daniel-kurushin/arm-quantum/old/Календарь/Календарь.docx

Июль
Пн | Вт | Ср | Чт | Пт | Сб | Вс
1) Создание прототипа | 2) Создание прототипа | 3) Создание прототипа | 4) Создание прототипа | 5) Создание прототипа | 6) Создание прототипа | 7) Создание прототипа
8) Создание прототипа | 9) Создание прототипа | 10) Создание прототипа | 11) Проекти- рование РМ-120 | 12) Создание Моделей, Печать Деталей | 13) Создание РМ-120 | 14) Создание Модели РМ-150
15) Написание ПО | 16) Написание ПО Создание Моделей | 17) Проекти- Рование РМ-220 и РМ-110, Написание ПО | 18) Проекти- Рование РМ-220 и РМ-110, Написание ПО | 19) Проекти- Рование РМ-220 и РМ-110, Написание ПО | 20) Создание модели и печать РМ-211 Написание ПО | 21) Создание Модели и печать РМ- 213 Написание ПО
22) Создание Модели и Печать РМ- 214, Написание ПО | 23) Сборка тестовой версии РМ- 210, Написание ПО | 24) Сборка тестовой версии РМ-210 | 25) Сборка тестовой версии РМ-110 | 26) Сборка Тестовой версии РМ-110 | 27) Проекти-рование РМ-250, Написание ПО | 28) Проекти-рование РМ-261, РМ-262, РМ-263.
29) Написание ПО | 30) Написание ПО, Проведение тестов | 31) Написание ПО, Проведение тестов

Август
Пн | Вт | Ср | Чт | Пт | Сб | Вс
| | | 1) Сборка РМ-210 | 2) Сборка РМ-210 | 3) Сборка РМ-210 | 4) Сборка РМ-210
5) Сборка РМ-110 | 6) Сборка РМ-110 | 7) Сборка РМ-110 | 8) Написание ПО | 9) Написание ПО | 10) Написание ПО | 11) Проекти-рование РМ-220
12) Проекти-рование РМ-220 | 13) Проекти-рование РМ-220 | 14) Создание моделей РМ-220 | 15) Создание моделей РМ-220 | 16) Создание моделей РМ-220 | 17) Написание ПО, Проведение тестов | 18) Написание ПО, Проведение тестов
19) Печать моделей | 20) Печать моделей | 21) Проведение тестов | 22) Проектирование РМ-500 | 23) Проектирование РМ-500 | 24) Создание моделей | 25) Написание ПО
26) | 27) | 28) | 29) | 30) | 31)
