daniel-kurushin/arm-quantum/IMG_20211010_125608.jpg

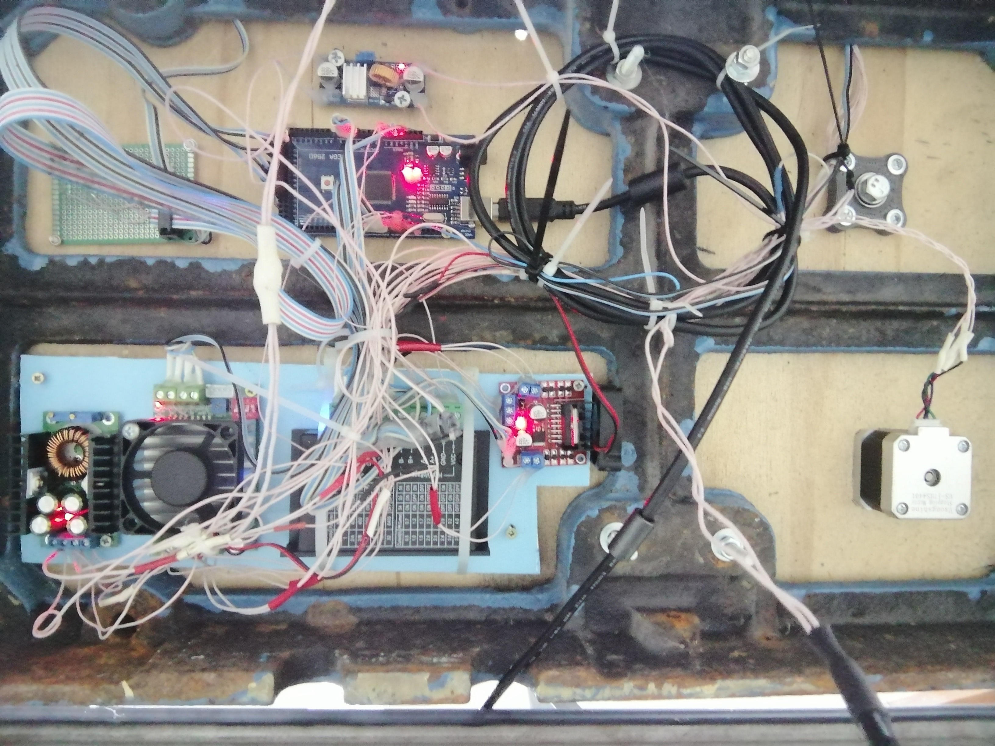
IMG_20211010_125608.jpg
