daniel-kurushin/arm-quantum/res.png

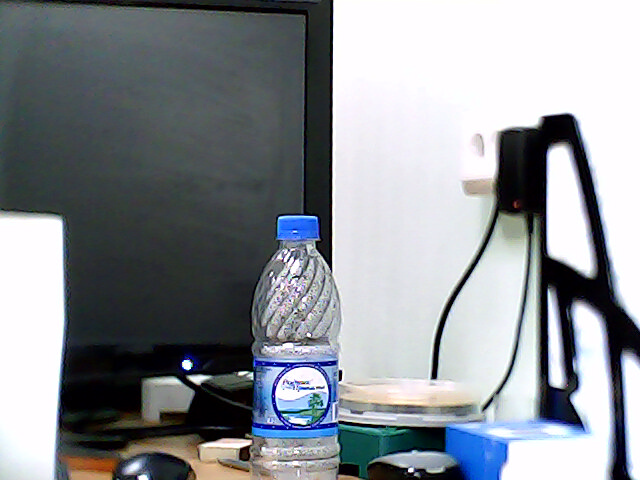
res.png
