daniel-kurushin/arm-quantum/РМ-000 Рука-манипулятор/РМ-100 Шасси/2.jpeg

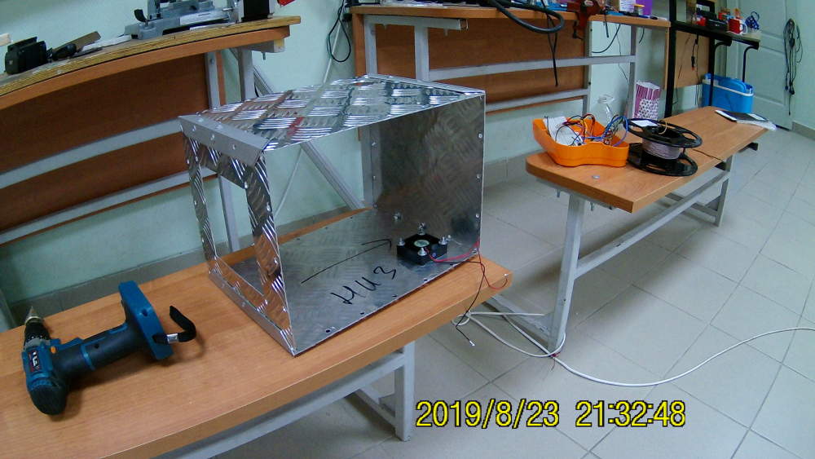
РМ-000 Рука-манипулятор/РМ-100 Шасси/2.jpeg
