daniel-kurushin/arm-quantum/РМ-000 Рука-манипулятор/РМ-100 Шасси/3.jpeg

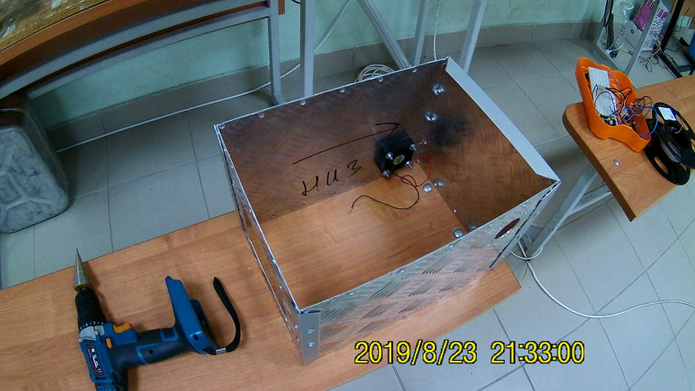
РМ-000 Рука-манипулятор/РМ-100 Шасси/3.jpeg
