daniel-kurushin/arm-quantum/РМ-000 Рука-манипулятор/РМ-100 Шасси/РМ-110 Корпус/корпус.jpeg

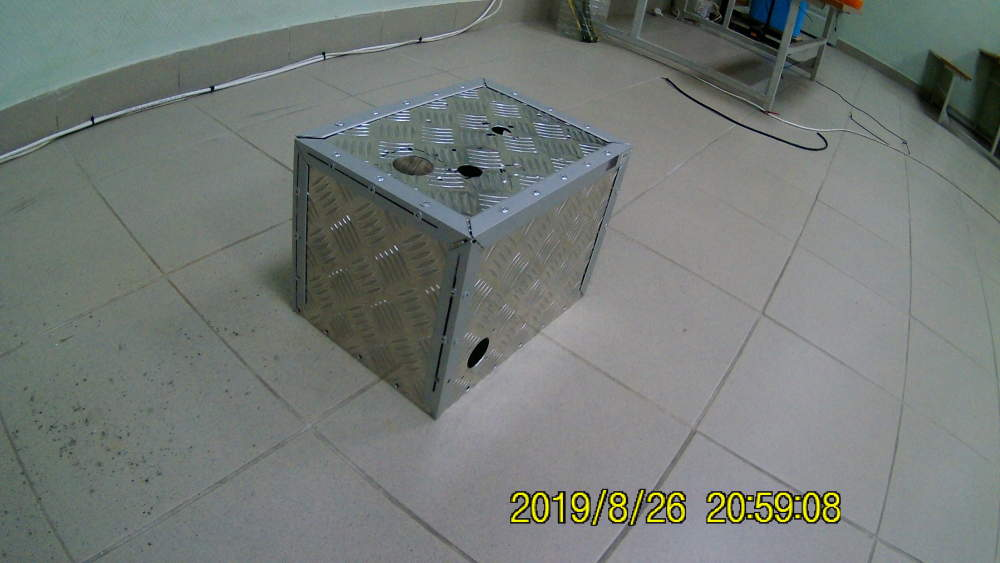
РМ-000 Рука-манипулятор/РМ-100 Шасси/РМ-110 Корпус/корпус.jpeg
