daniel-kurushin/arm-quantum/РМ-000 Рука-манипулятор/РМ-100 Шасси/РМ-120 Винтовые упоры/IMG_20190822_140116.jpg

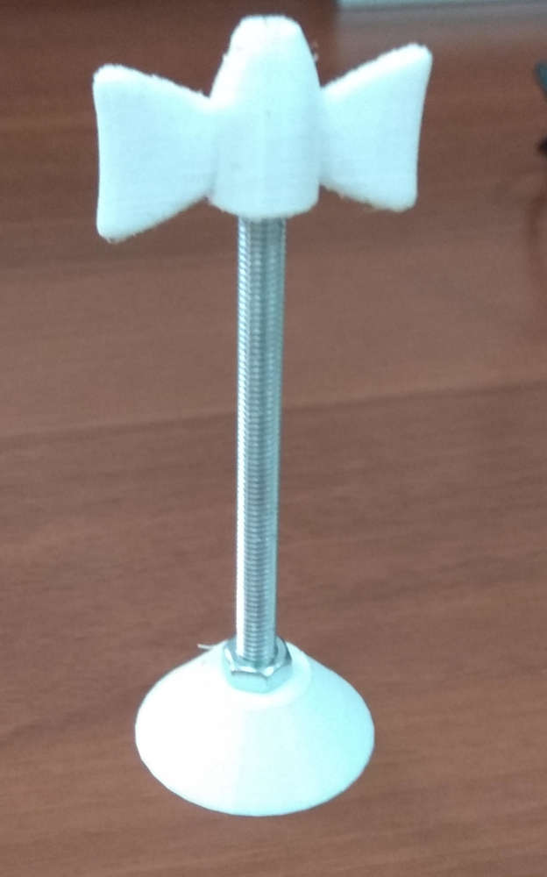
РМ-000 Рука-манипулятор/РМ-100 Шасси/РМ-120 Винтовые упоры/IMG_20190822_140116.jpg
