daniel-kurushin/arm-quantum/РМ-000 Рука-манипулятор/РМ-200 Опорно-поворотное устройство/предварительная_сборка.jpg

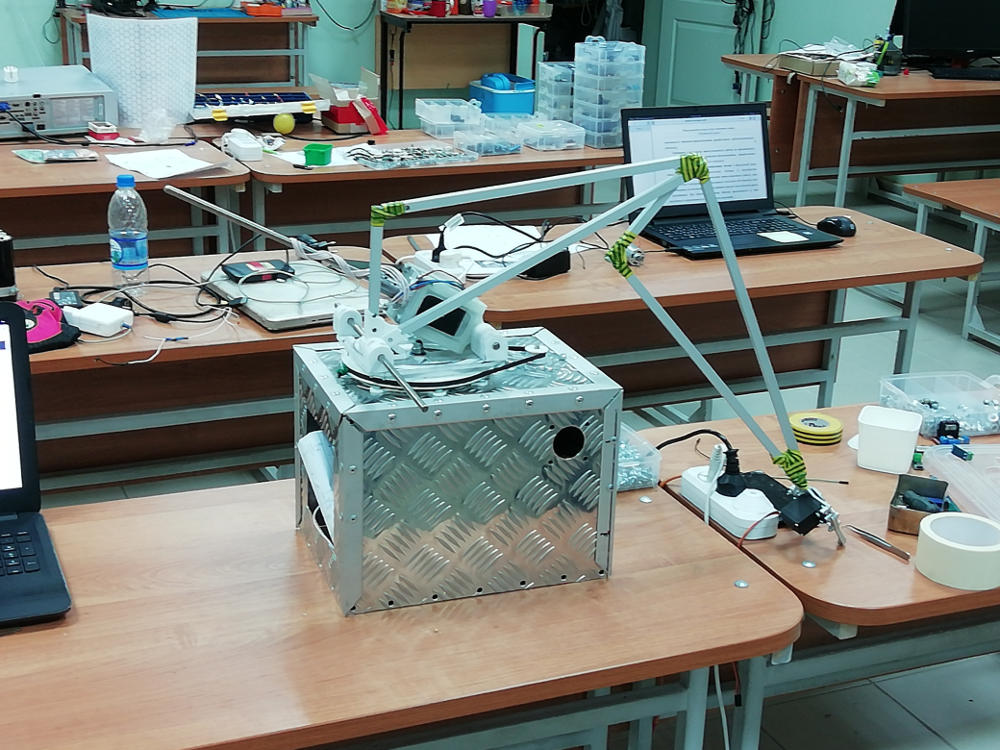
РМ-000 Рука-манипулятор/РМ-200 Опорно-поворотное устройство/предварительная_сборка.jpg
