daniel-kurushin/arm-quantum/РМ-000 Рука-манипулятор/РМ-200 Опорно-поворотное устройство/РМ-220 Стрела/FHD0012.JPG

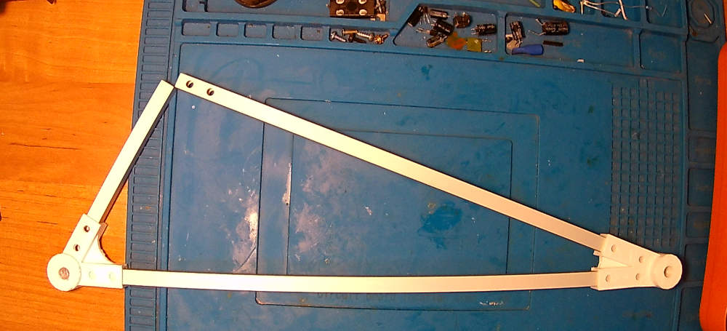
РМ-000 Рука-манипулятор/РМ-200 Опорно-поворотное устройство/РМ-220 Стрела/FHD0012.JPG
