daniel-kurushin/arm-quantum/РМ-000 Рука-манипулятор/РМ-200 Опорно-поворотное устройство/РМ-220 Стрела/крепеж_стрелы_1_(тест).jpg

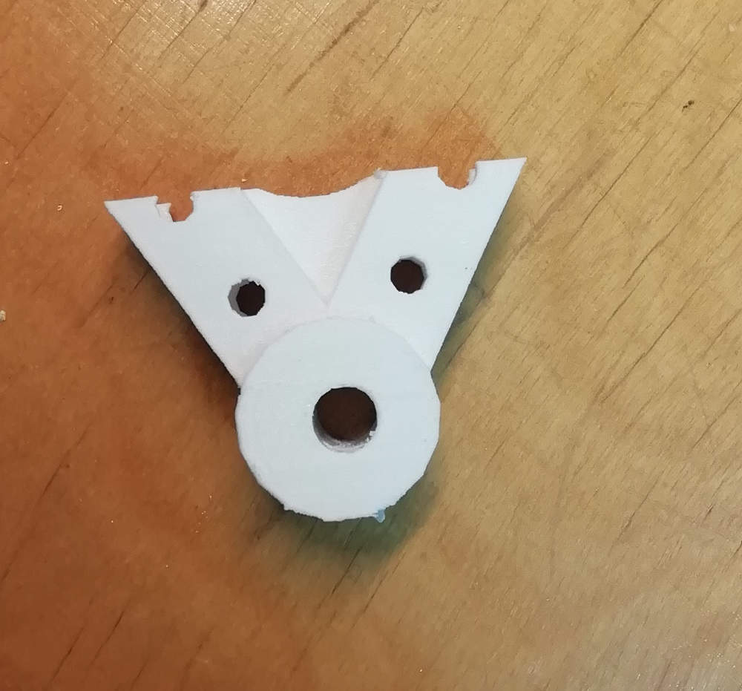
РМ-000 Рука-манипулятор/РМ-200 Опорно-поворотное устройство/РМ-220 Стрела/крепеж_стрелы_1_(тест).jpg
