daniel-kurushin/arm-quantum/РМ-000 Рука-манипулятор/РМ-200 Опорно-поворотное устройство/РМ-261 Привод РМ-220/РМ-261-01 Корпус опорных подшипников РМ-261-09 для дивгателя РМ-261-04/FHD0003.JPG

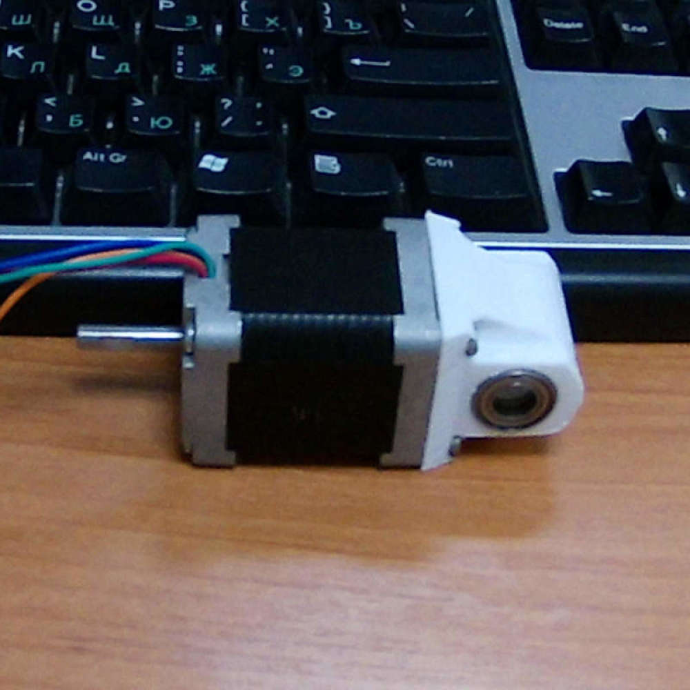
РМ-000 Рука-манипулятор/РМ-200 Опорно-поворотное устройство/РМ-261 Привод РМ-220/РМ-261-01 Корпус опорных подшипников РМ-261-09 для дивгателя РМ-261-04/FHD0003.JPG
