daniel-kurushin/arm-quantum/РМ-000 Рука-манипулятор/РМ-200 Опорно-поворотное устройство/РМ-261 Привод РМ-220/РМ-261-02 Корпус РМ-261-05/FHD0001.JPG

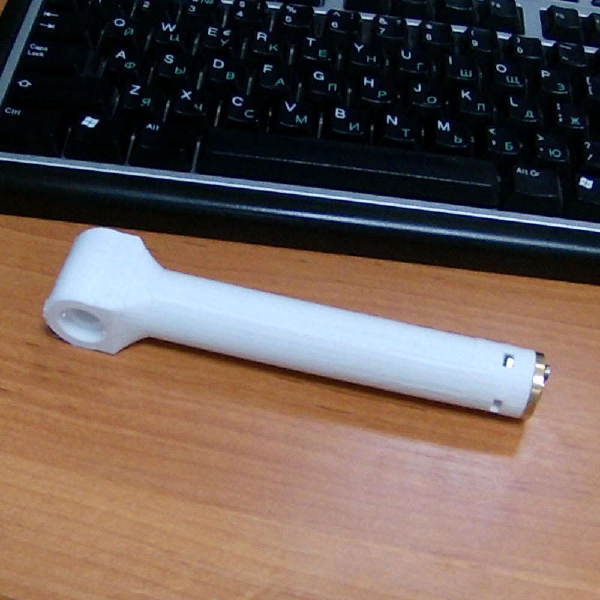
РМ-000 Рука-манипулятор/РМ-200 Опорно-поворотное устройство/РМ-261 Привод РМ-220/РМ-261-02 Корпус РМ-261-05/FHD0001.JPG
