daniel-kurushin/arm-quantum/РМ-000 Рука-манипулятор/РМ-200 Опорно-поворотное устройство/РМ-261 Привод РМ-220/РМ-261-03 Муфта соединительная (взамен покупной)/FHD0006.JPG

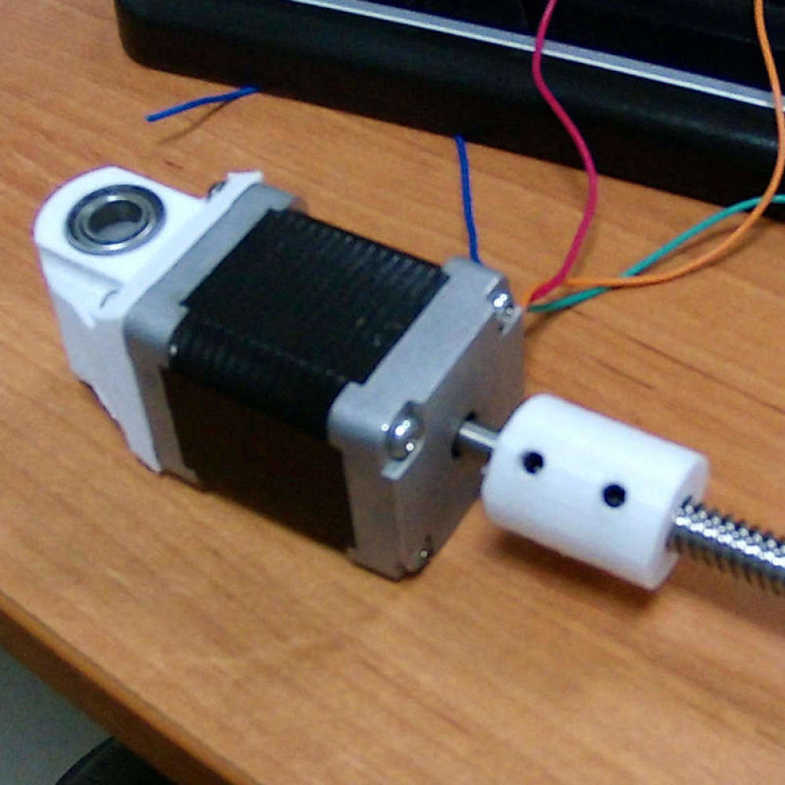
РМ-000 Рука-манипулятор/РМ-200 Опорно-поворотное устройство/РМ-261 Привод РМ-220/РМ-261-03 Муфта соединительная (взамен покупной)/FHD0006.JPG
