daniel-kurushin/arm-quantum/РМ-000 Рука-манипулятор/РМ-300 Блок управления/РМ-330 Драйвера приводов/драйвера_ШД.jpg

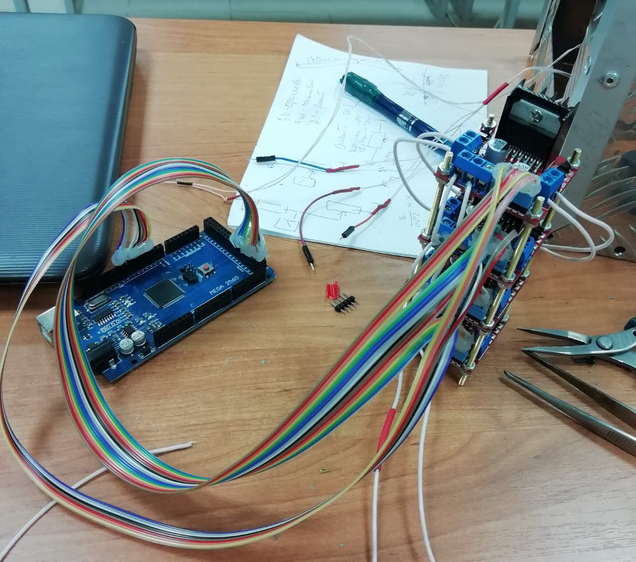
РМ-000 Рука-манипулятор/РМ-300 Блок управления/РМ-330 Драйвера приводов/драйвера_ШД.jpg
