daniel-kurushin/arm-quantum/РМ-000 Рука-манипулятор/РМ-400 Система технического зрения/РМ-430 Программное обеспечение/РМ-431 Распознавание образов/capacitor/1.jpg

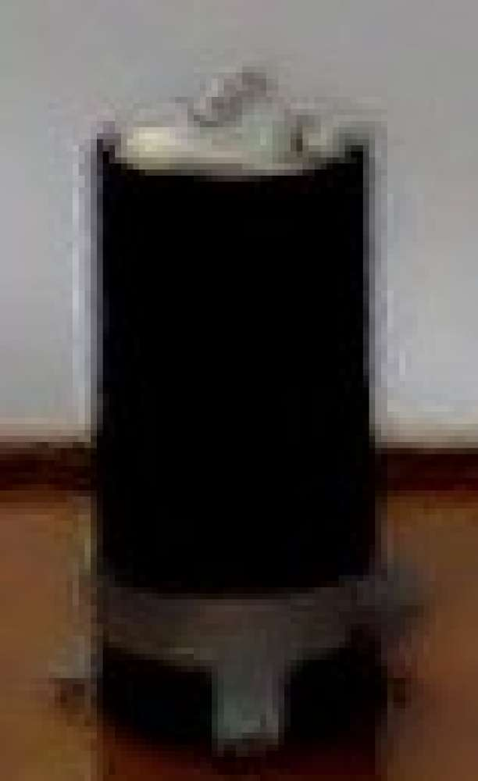
РМ-000 Рука-манипулятор/РМ-400 Система технического зрения/РМ-430 Программное обеспечение/РМ-431 Распознавание образов/capacitor/1.jpg
