daniel-kurushin/arm-quantum/РМ-000 Рука-манипулятор/РМ-100 Шасси/РМ-110 Корпус/плита переходная.stl

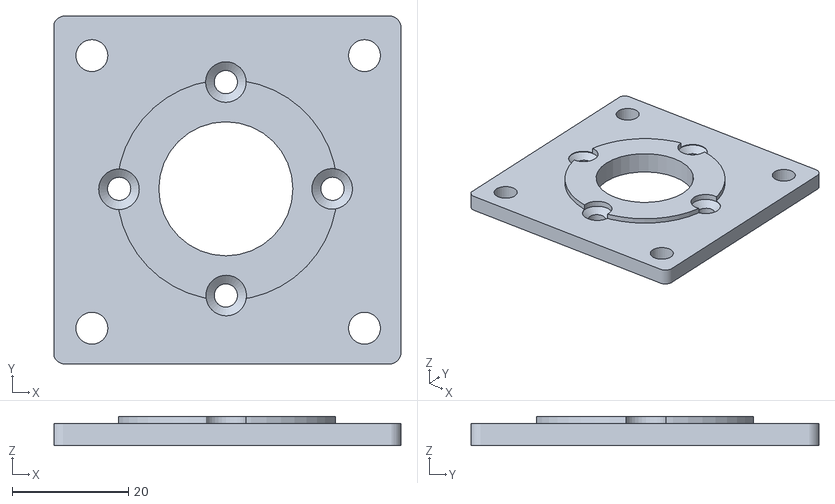
[picture p50: CAD file, 2019-09-23]
РМ-000 Рука-манипулятор/РМ-100 Шасси/РМ-110 Корпус/плита переходная.stl
59.8 x 59.9 x 5.00
