daniel-kurushin/arm-quantum/РМ-000 Рука-манипулятор/РМ-100 Шасси/РМ-120 Винтовые упоры/Кронштейн-1.stl

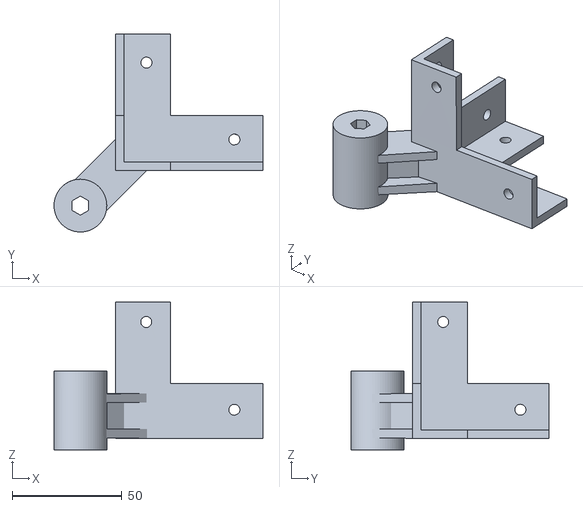
[picture p51: CAD file, 2019-09-15]
РМ-000 Рука-манипулятор/РМ-100 Шасси/РМ-120 Винтовые упоры/Кронштейн-1.stl
95.1 x 90.1 x 67.2
