daniel-kurushin/arm-quantum/РМ-000 Рука-манипулятор/РМ-100 Шасси/РМ-150 Контейнер АКБ/РМ-151 АКБ/АКБ-1.stl

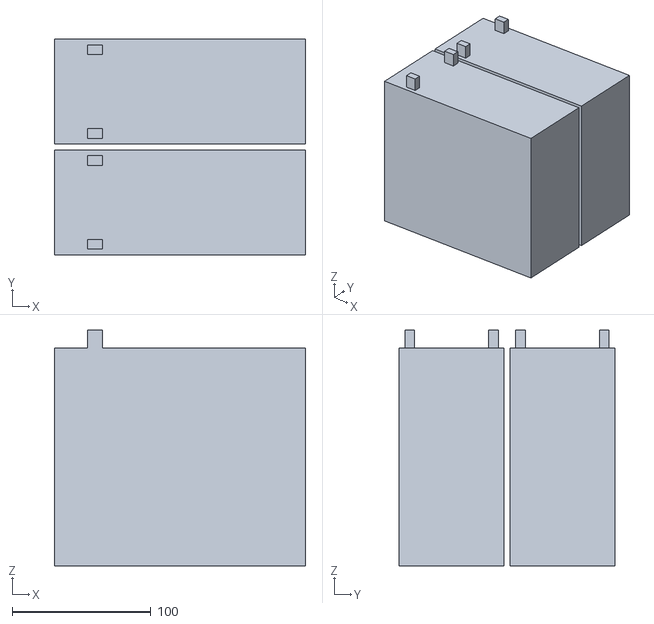
[picture p52: CAD file, 2019-08-23]
РМ-000 Рука-манипулятор/РМ-100 Шасси/РМ-150 Контейнер АКБ/РМ-151 АКБ/АКБ-1.stl
181.0 x 156.0 x 170.0
