daniel-kurushin/arm-quantum/РМ-000 Рука-манипулятор/РМ-100 Шасси/шкив датчика_1.stl

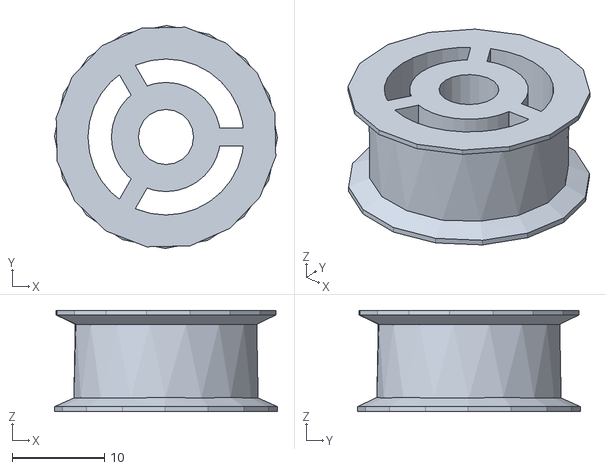
[picture p53: CAD file, 2019-10-10]
РМ-000 Рука-манипулятор/РМ-100 Шасси/шкив датчика_1.stl
24.2 x 24.2 x 11.0
