daniel-kurushin/arm-quantum/РМ-000 Рука-манипулятор/РМ-200 Опорно-поворотное устройство/РМ-210 Поворотный механизм/РМ-211 Узел осевого подшипника/РМ-211-01 Корпус подшипников оси/Корпус подшипника.stl

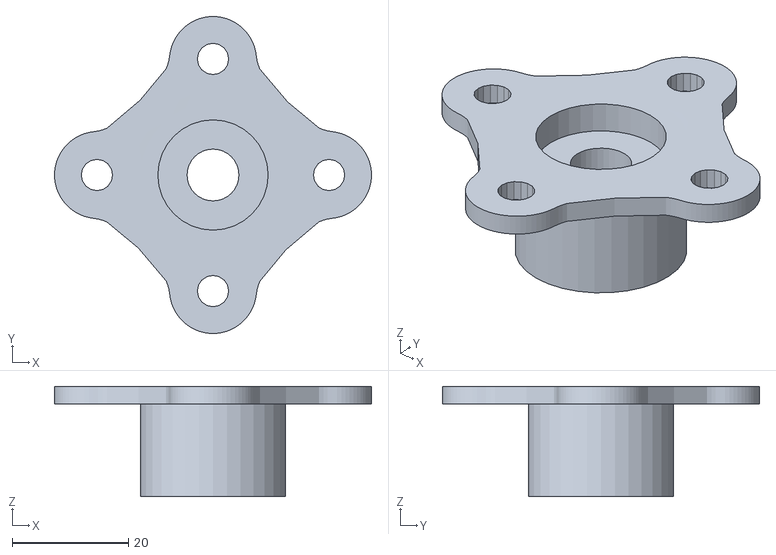
[picture p54: CAD file, 2019-08-14]
РМ-000 Рука-манипулятор/РМ-200 Опорно-поворотное устройство/РМ-210 Поворотный механизм/РМ-211 Узел осевого подшипника/РМ-211-01 Корпус подшипников оси/Корпус подшипника.stl
54.6 x 54.6 x 19.0
