daniel-kurushin/arm-quantum/РМ-000 Рука-манипулятор/РМ-200 Опорно-поворотное устройство/РМ-210 Поворотный механизм/РМ-212 Узел опорного подшипника/РМ-212-02 Сепаратор опорного подшипника/Cепаратор опорного подшипника.stl

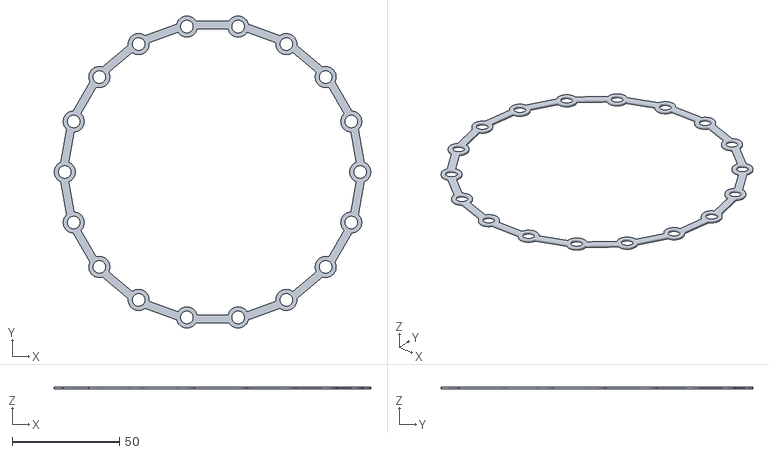
[picture p56: CAD file, 2019-08-13]
РМ-000 Рука-манипулятор/РМ-200 Опорно-поворотное устройство/РМ-210 Поворотный механизм/РМ-212 Узел опорного подшипника/РМ-212-02 Сепаратор опорного подшипника/Cепаратор опорного подшипника.stl
148.0 x 145.8 x 1.00
