daniel-kurushin/arm-quantum/РМ-000 Рука-манипулятор/РМ-200 Опорно-поворотное устройство/РМ-210 Поворотный механизм/РМ-213 Узел натяжителя (датчика положения)/РМ-213-01 Корпус натяжителя/корпус.stl

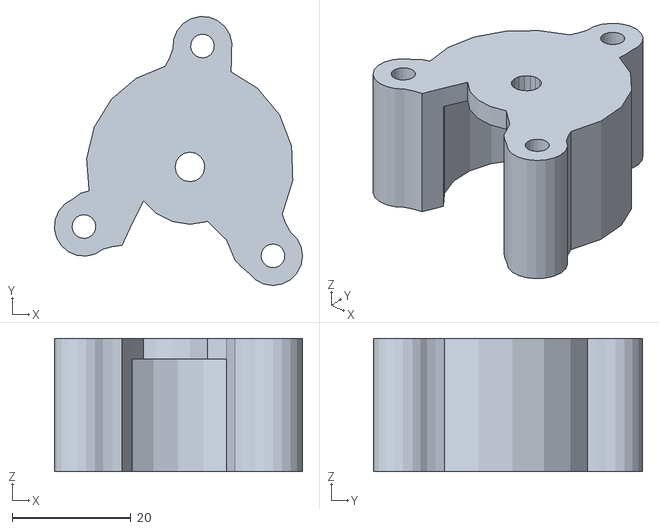
[picture p57: CAD file, 2019-08-18]
РМ-000 Рука-манипулятор/РМ-200 Опорно-поворотное устройство/РМ-210 Поворотный механизм/РМ-213 Узел натяжителя (датчика положения)/РМ-213-01 Корпус натяжителя/корпус.stl
41.9 x 45.4 x 22.5
