daniel-kurushin/arm-quantum/РМ-000 Рука-манипулятор/РМ-200 Опорно-поворотное устройство/РМ-210 Поворотный механизм/РМ-213 Узел натяжителя (датчика положения)/РМ-213-02 Крышка корпуса натяжителя/крышка.stl

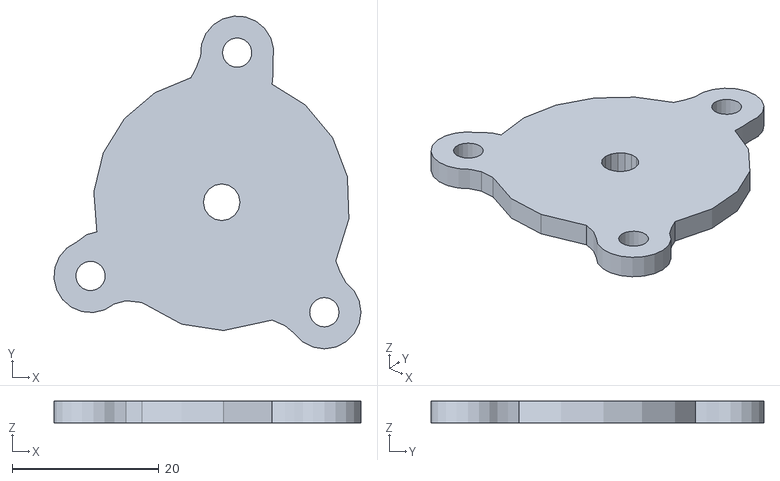
[picture p58: CAD file, 2019-08-18]
РМ-000 Рука-манипулятор/РМ-200 Опорно-поворотное устройство/РМ-210 Поворотный механизм/РМ-213 Узел натяжителя (датчика положения)/РМ-213-02 Крышка корпуса натяжителя/крышка.stl
41.9 x 45.4 x 3.00
