daniel-kurushin/arm-quantum/РМ-000 Рука-манипулятор/РМ-200 Опорно-поворотное устройство/РМ-210 Поворотный механизм/РМ-213 Узел натяжителя (датчика положения)/РМ-213-04 Шкив натяжителя (датчика положения)/шкив-1.stl

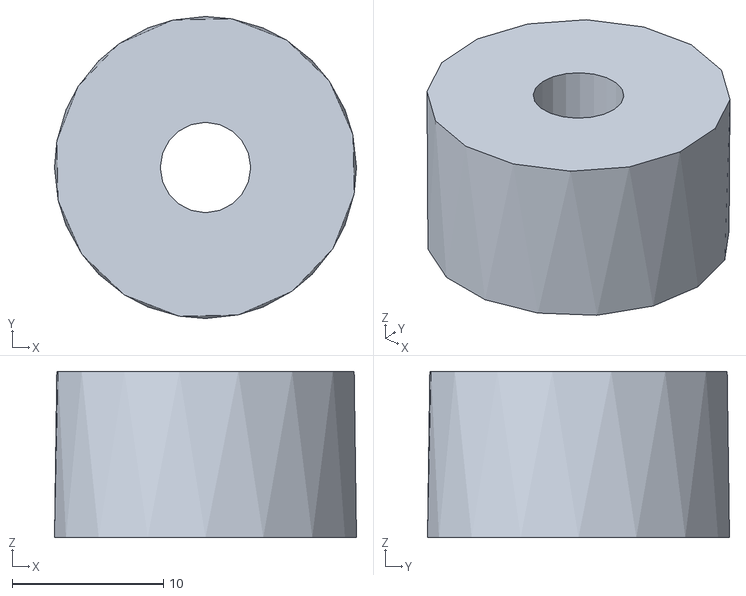
[picture p59: CAD file, 2019-08-19]
РМ-000 Рука-манипулятор/РМ-200 Опорно-поворотное устройство/РМ-210 Поворотный механизм/РМ-213 Узел натяжителя (датчика положения)/РМ-213-04 Шкив натяжителя (датчика положения)/шкив-1.stl
20.0 x 20.0 x 11.0
