daniel-kurushin/arm-quantum/РМ-000 Рука-манипулятор/РМ-200 Опорно-поворотное устройство/РМ-210 Поворотный механизм/РМ-213 Узел натяжителя (датчика положения)/РМ-213-07 Поворотный рычаг шкива (держатель РМ-213-03)/рычаг.stl

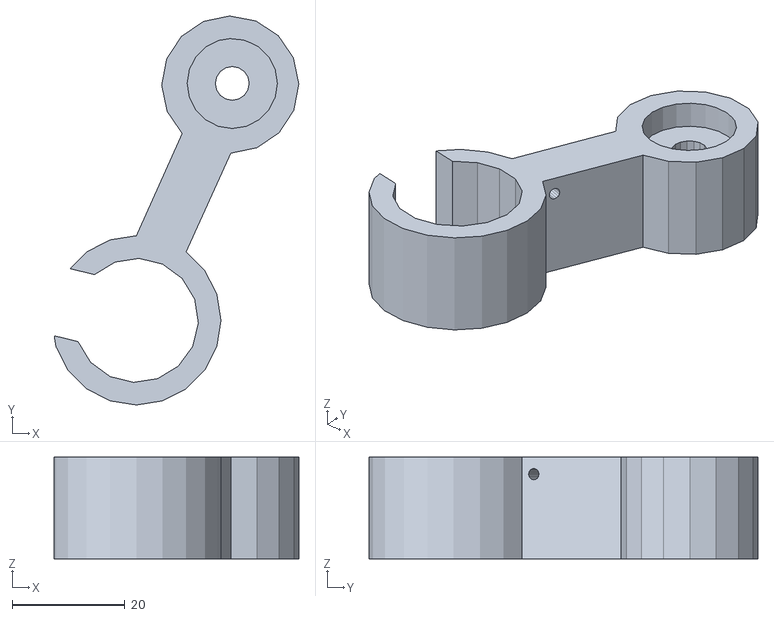
[picture p60: CAD file, 2019-08-18]
РМ-000 Рука-манипулятор/РМ-200 Опорно-поворотное устройство/РМ-210 Поворотный механизм/РМ-213 Узел натяжителя (датчика положения)/РМ-213-07 Поворотный рычаг шкива (держатель РМ-213-03)/рычаг.stl
43.4 x 68.9 x 18.0
