daniel-kurushin/arm-quantum/РМ-000 Рука-манипулятор/РМ-200 Опорно-поворотное устройство/РМ-210 Поворотный механизм/РМ-214 Узел поворотного основания/РМ-214-01 Шкив ведомый с верхней обоймой опорного подшипника/ Шкив ведомый-1.stl

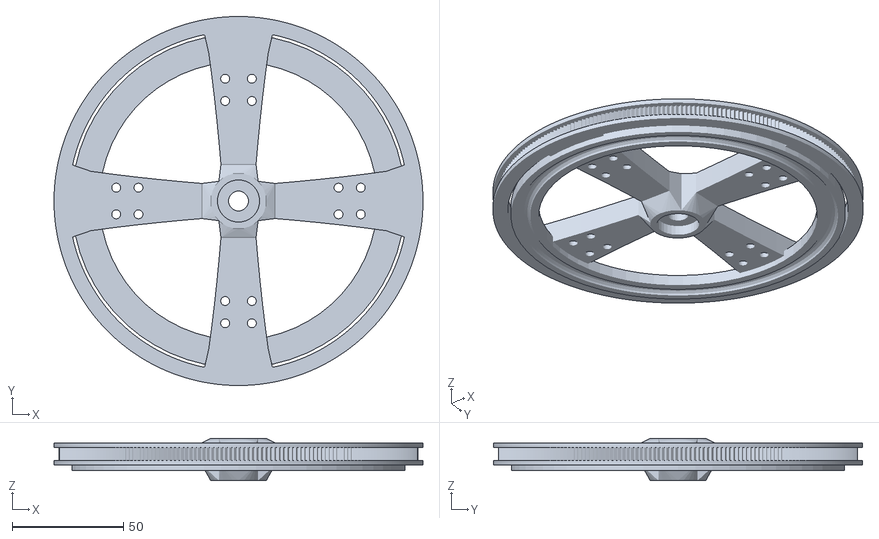
[picture p61: CAD file, 2019-08-21]
РМ-000 Рука-манипулятор/РМ-200 Опорно-поворотное устройство/РМ-210 Поворотный механизм/РМ-214 Узел поворотного основания/РМ-214-01 Шкив ведомый с верхней обоймой опорного подшипника/ Шкив ведомый-1.s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
166.0 x 166.0 x 19.0
