daniel-kurushin/arm-quantum/РМ-000 Рука-манипулятор/РМ-200 Опорно-поворотное устройство/РМ-220 Стрела/подвес захвата.stl

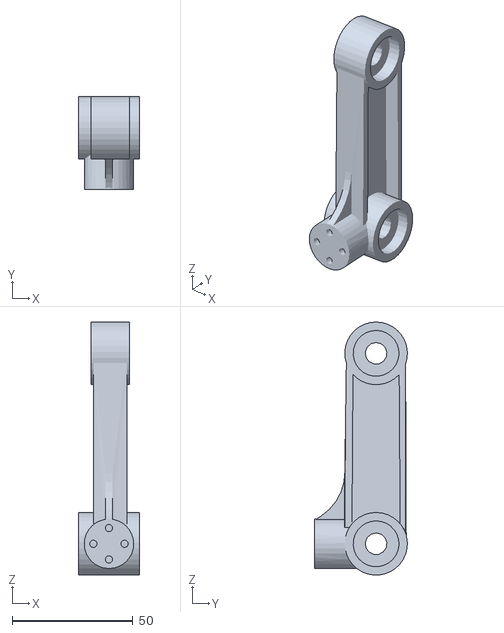
[picture p62: CAD file, 2019-09-23]
РМ-000 Рука-манипулятор/РМ-200 Опорно-поворотное устройство/РМ-220 Стрела/подвес захвата.stl
25.2 x 38.5 x 104.9
