daniel-kurushin/arm-quantum/РМ-000 Рука-манипулятор/РМ-200 Опорно-поворотное устройство/РМ-250 Привод РМ-210/Шкив ведущий.stl

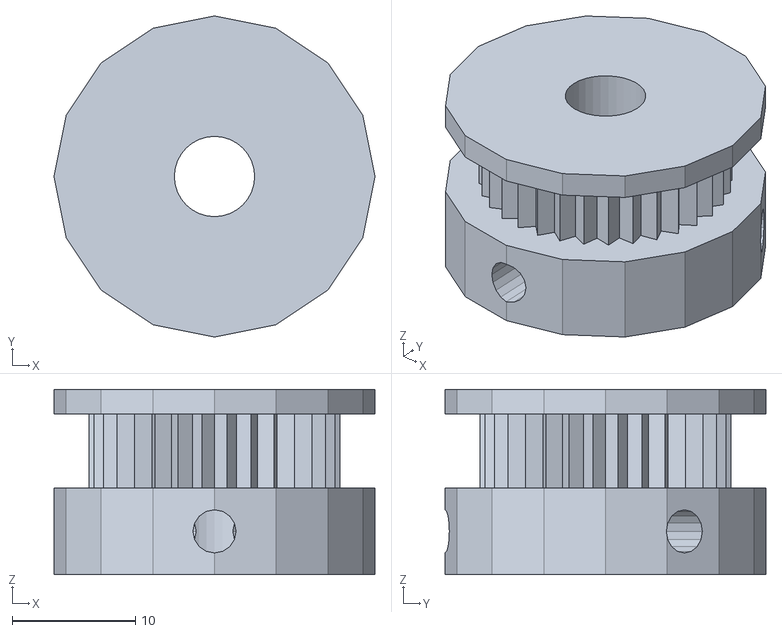
[picture p63: CAD file, 2019-08-14]
РМ-000 Рука-манипулятор/РМ-200 Опорно-поворотное устройство/РМ-250 Привод РМ-210/Шкив ведущий.stl
26.0 x 26.0 x 15.0
