daniel-kurushin/arm-quantum/РМ-000 Рука-манипулятор/РМ-200 Опорно-поворотное устройство/РМ-261 Привод РМ-220/РМ-261-01 Корпус опорных подшипников РМ-261-09 для дивгателя РМ-261-04/РМ-261-01-1.stl

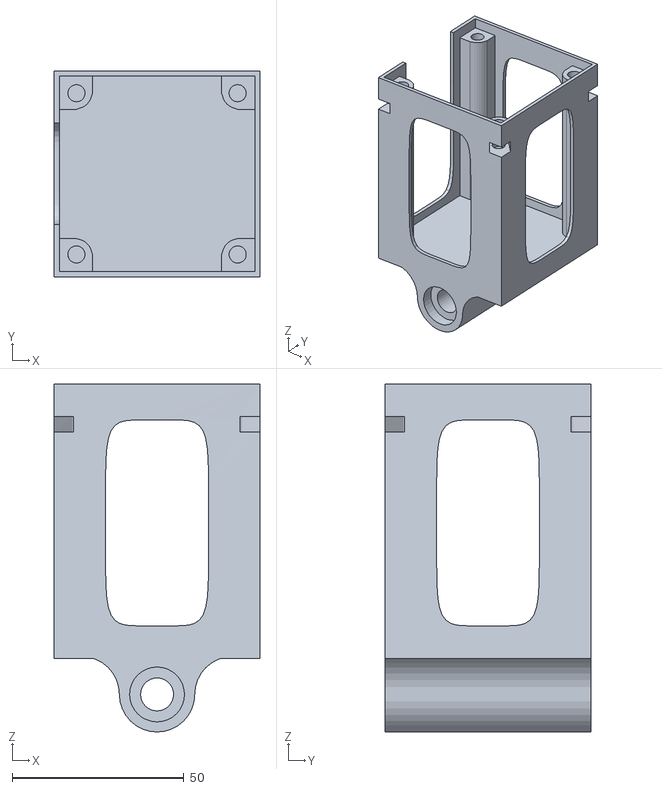
[picture p64: CAD file, 2019-08-11]
РМ-000 Рука-манипулятор/РМ-200 Опорно-поворотное устройство/РМ-261 Привод РМ-220/РМ-261-01 Корпус опорных подшипников РМ-261-09 для дивгателя РМ-261-04/РМ-261-01-1.stl
60.0 x 60.1 x 101.4
