daniel-kurushin/arm-quantum/РМ-000 Рука-манипулятор/РМ-200 Опорно-поворотное устройство/РМ-261 Привод РМ-220/РМ-261-03 Муфта соединительная (взамен покупной)/РМ-261-03.stl

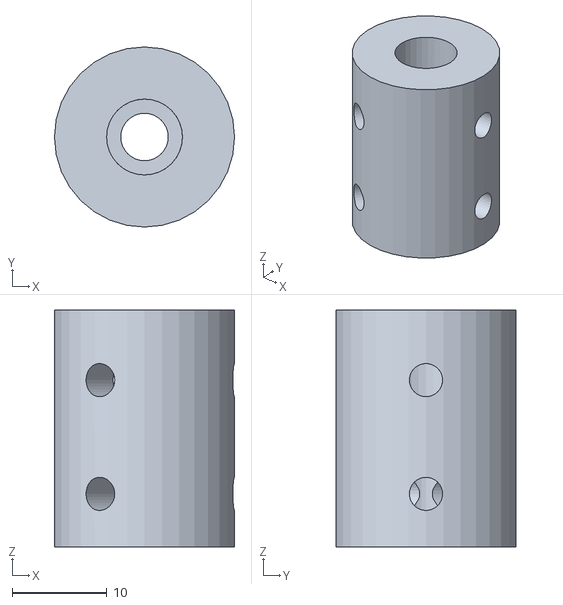
[picture p65: CAD file, 2019-08-09]
РМ-000 Рука-манипулятор/РМ-200 Опорно-поворотное устройство/РМ-261 Привод РМ-220/РМ-261-03 Муфта соединительная (взамен покупной)/РМ-261-03.stl
19.0 x 19.0 x 25.0
