daniel-kurushin/arm-quantum/РМ-000 Рука-манипулятор/РМ-200 Опорно-поворотное устройство/РМ-261 Привод РМ-220/РМ-261-04 Двигатель шаговый PL35HD45-D5/РМ-261-04 Двигатель шаговый.stl

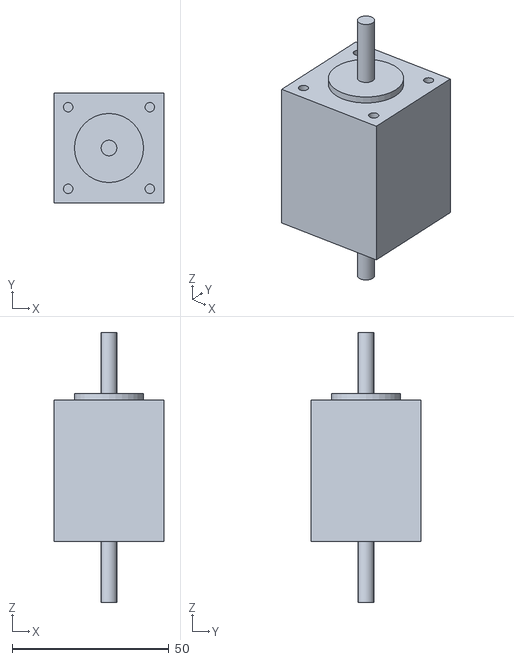
[picture p66: CAD file, 2019-08-09]
РМ-000 Рука-манипулятор/РМ-200 Опорно-поворотное устройство/РМ-261 Привод РМ-220/РМ-261-04 Двигатель шаговый PL35HD45-D5/РМ-261-04 Двигатель шаговый.stl
35.0 x 35.0 x 86.0
