daniel-kurushin/arm-quantum/РМ-000 Рука-манипулятор/РМ-200 Опорно-поворотное устройство/РМ-262 Привод РМ-230/РМ-262-01 Корпус опорных подшипников РМ-262-09 для дивгателя РМ-262-04/РМ-262-02.stl

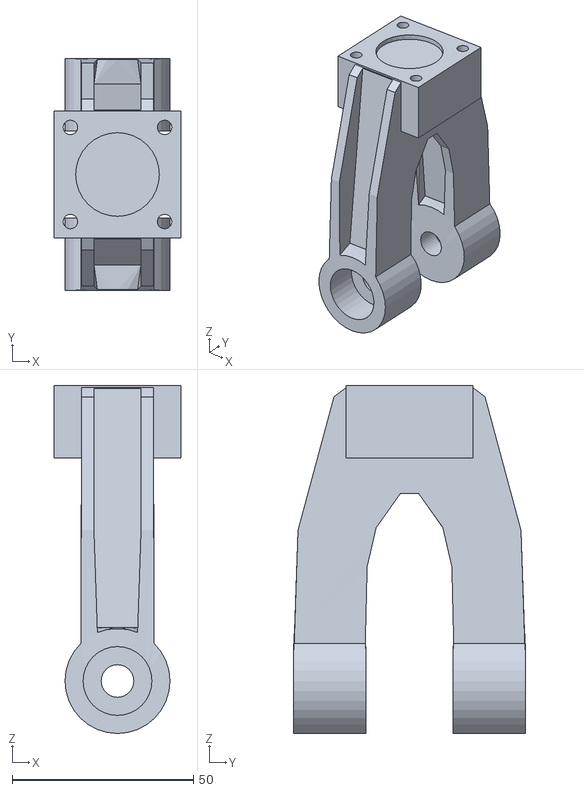
[picture p67: CAD file, 2019-09-19]
РМ-000 Рука-манипулятор/РМ-200 Опорно-поворотное устройство/РМ-262 Привод РМ-230/РМ-262-01 Корпус опорных подшипников РМ-262-09 для дивгателя РМ-262-04/РМ-262-02.stl
35.0 x 64.0 x 96.1
