daniel-kurushin/arm-quantum/РМ-000 Рука-манипулятор/РМ-200 Опорно-поворотное устройство/РМ-262 Привод РМ-230/РМ-262-02 Корпус РМ-262-05/РМ-262-02.stl

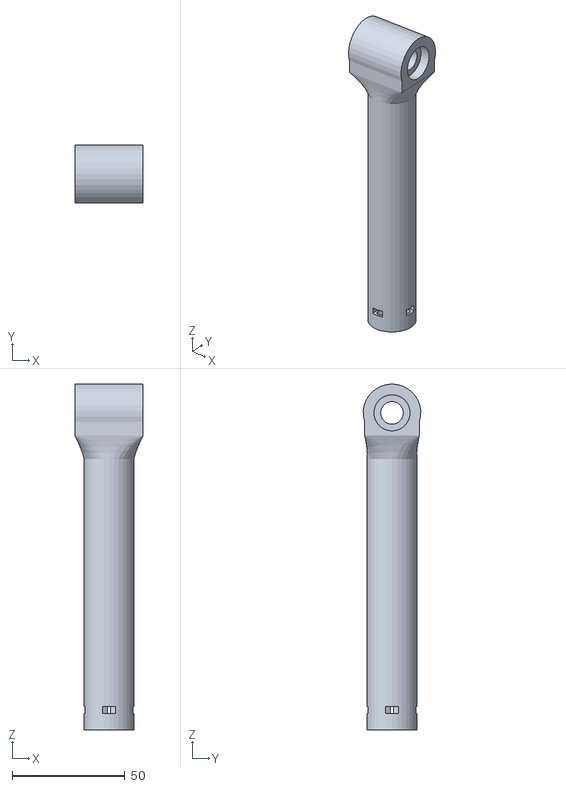
[picture p68: CAD file, 2019-08-08]
РМ-000 Рука-манипулятор/РМ-200 Опорно-поворотное устройство/РМ-262 Привод РМ-230/РМ-262-02 Корпус РМ-262-05/РМ-262-02.stl
30.3 x 25.5 x 153.1
