daniel-kurushin/arm-quantum/РМ-000 Рука-манипулятор/РМ-500 Схват/clawsl.stl

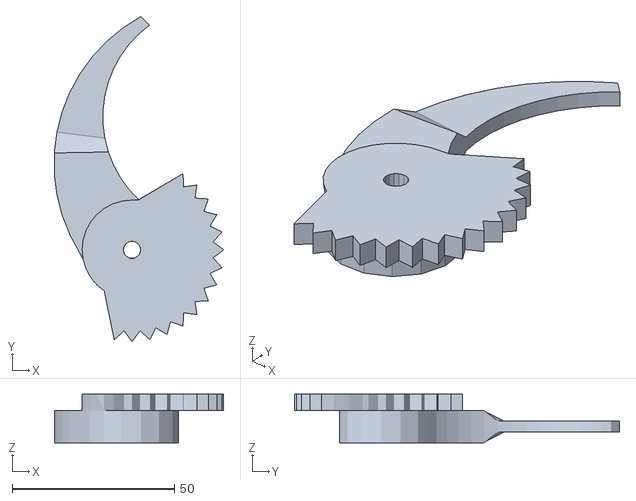
[picture p69: CAD file, 2021-01-24]
РМ-000 Рука-манипулятор/РМ-500 Схват/clawsl.stl
52.3 x 100.3 x 15.0
