daniel-kurushin/arm-quantum/РМ-000 Рука-манипулятор/РМ-600 Пульт управления/РМ-630 Управляющая ЭВМ/РМ-632 Устройства отображения информации/РМ-632-01 Кронштейн и корпус монитора/small-monitor-frame-a.stl

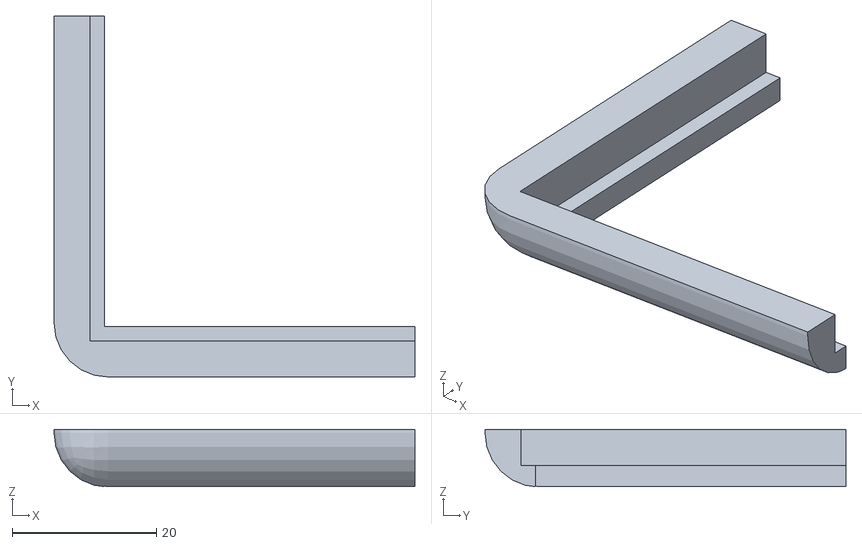
[picture p70: CAD file, 2021-10-18]
РМ-000 Рука-манипулятор/РМ-600 Пульт управления/РМ-630 Управляющая ЭВМ/РМ-632 Устройства отображения информации/РМ-632-01 Кронштейн и корпус монитора/small-monitor-frame-a.stl
50.0 x 50.0 x 7.93
