daniel-kurushin/arm-quantum/РМ-000 Рука-манипулятор/РМ-100 Шасси/РМ-110 Корпус/untitled.stl

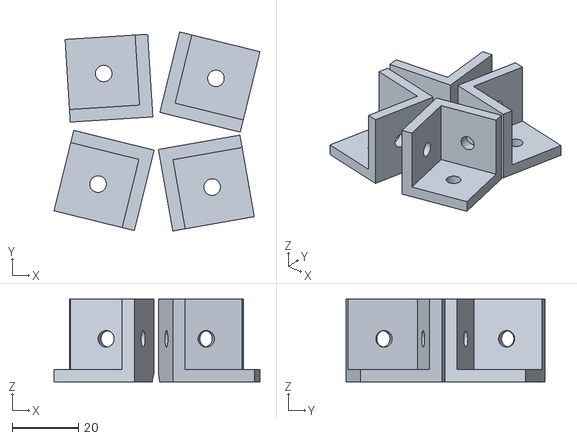
[picture p71: CAD file, 2019-08-31]
РМ-000 Рука-манипулятор/РМ-100 Шасси/РМ-110 Корпус/untitled.stl
62.2 x 60.1 x 25.0
