daniel-kurushin/arm-quantum/РМ-000 Рука-манипулятор/РМ-100 Шасси/РМ-120 Винтовые упоры/Кронштейн4.stl

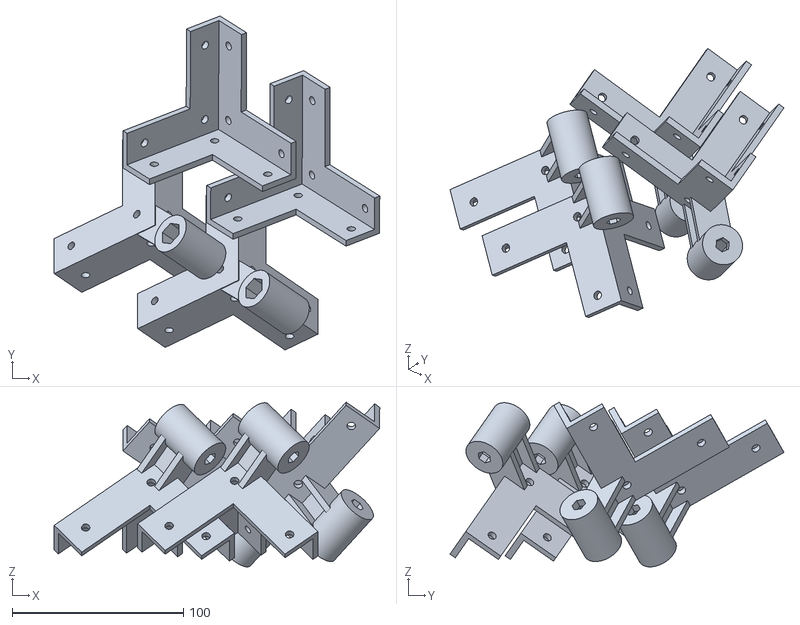
[picture p72: CAD file, 2019-08-21]
РМ-000 Рука-манипулятор/РМ-100 Шасси/РМ-120 Винтовые упоры/Кронштейн4.stl
190.3 x 195.2 x 96.3
