daniel-kurushin/arm-quantum/РМ-000 Рука-манипулятор/РМ-100 Шасси/РМ-150 Контейнер АКБ/РМ-151 АКБ/АКБ.stl

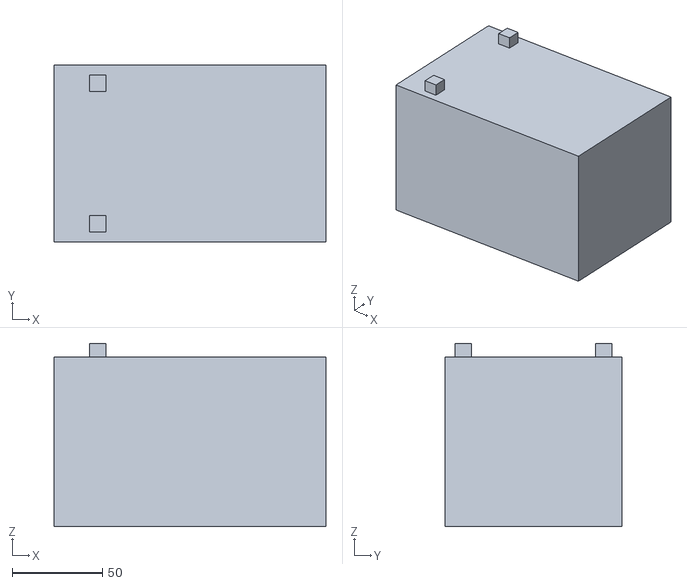
[picture p73: CAD file, 2019-08-23]
РМ-000 Рука-манипулятор/РМ-100 Шасси/РМ-150 Контейнер АКБ/РМ-151 АКБ/АКБ.stl
151.0 x 98.0 x 101.8
