daniel-kurushin/arm-quantum/РМ-000 Рука-манипулятор/РМ-200 Опорно-поворотное устройство/РМ-210 Поворотный механизм/РМ-212 Узел опорного подшипника/РМ-212-01 Обойма опорного подшипника нижняя/Опорный подшипник.stl

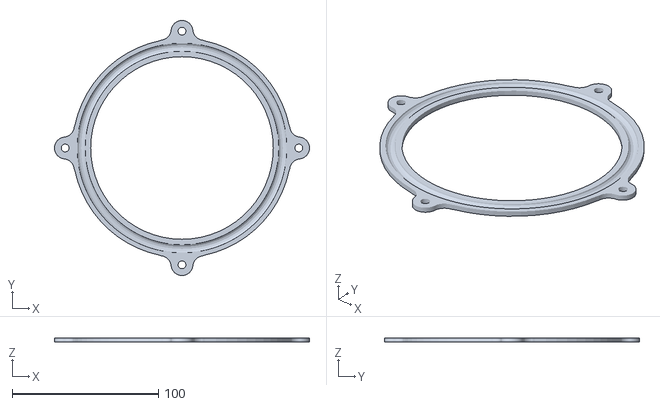
[picture p75: CAD file, 2019-08-13]
РМ-000 Рука-манипулятор/РМ-200 Опорно-поворотное устройство/РМ-210 Поворотный механизм/РМ-212 Узел опорного подшипника/РМ-212-01 Обойма опорного подшипника нижняя/Опорный подшипник.stl
174.6 x 174.6 x 3.00
