daniel-kurushin/arm-quantum/РМ-000 Рука-манипулятор/РМ-200 Опорно-поворотное устройство/РМ-210 Поворотный механизм/РМ-213 Узел натяжителя (датчика положения)/РМ-213-04 Шкив натяжителя (датчика положения)/шкив.stl

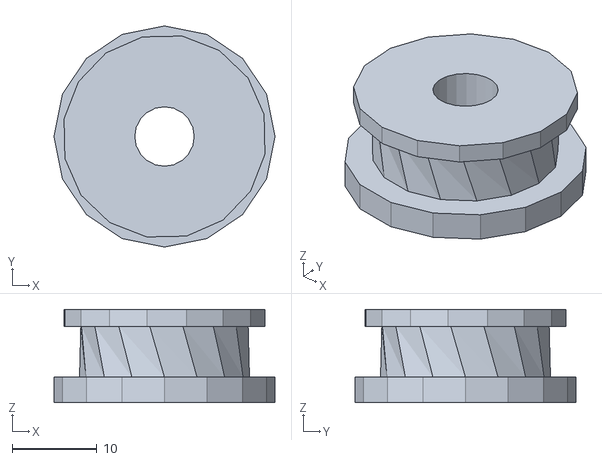
[picture p76: CAD file, 2019-08-14]
РМ-000 Рука-манипулятор/РМ-200 Опорно-поворотное устройство/РМ-210 Поворотный механизм/РМ-213 Узел натяжителя (датчика положения)/РМ-213-04 Шкив натяжителя (датчика положения)/шкив.stl
26.0 x 26.0 x 11.0
