daniel-kurushin/arm-quantum/РМ-000 Рука-манипулятор/РМ-200 Опорно-поворотное устройство/РМ-210 Поворотный механизм/РМ-214 Узел поворотного основания/РМ-214-01 Шкив ведомый с верхней обоймой опорного подшипника/ Шкив ведомый.stl

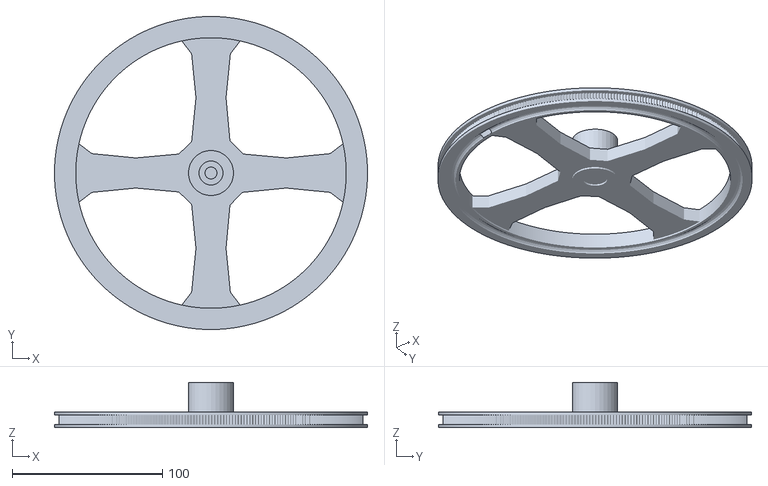
[picture p77: CAD file, 2019-08-10]
РМ-000 Рука-манипулятор/РМ-200 Опорно-поворотное устройство/РМ-210 Поворотный механизм/РМ-214 Узел поворотного основания/РМ-214-01 Шкив ведомый с верхней обоймой опорного подшипника/ Шкив ведомый.stl
208.0 x 208.0 x 30.0
