daniel-kurushin/arm-quantum/РМ-000 Рука-манипулятор/РМ-200 Опорно-поворотное устройство/РМ-220 Стрела/соединитель-6.stl

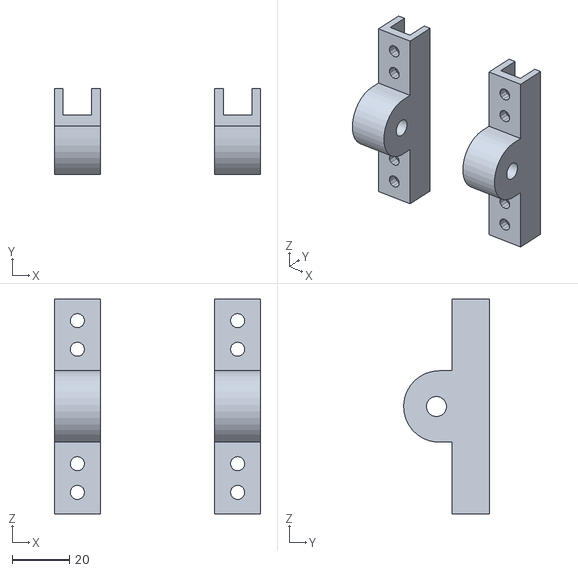
[picture p78: CAD file, 2019-09-23]
РМ-000 Рука-манипулятор/РМ-200 Опорно-поворотное устройство/РМ-220 Стрела/соединитель-6.stl
72.0 x 30.0 x 75.0
