daniel-kurushin/arm-quantum/РМ-000 Рука-манипулятор/РМ-200 Опорно-поворотное устройство/РМ-250 Привод РМ-210/Муфта соединительная.stl

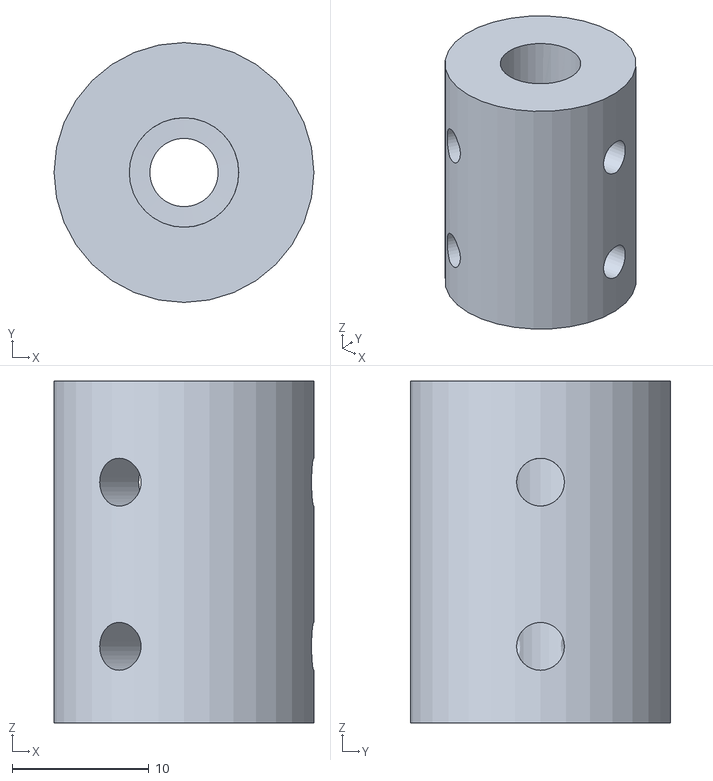
[picture p79: CAD file, 2019-08-10]
РМ-000 Рука-манипулятор/РМ-200 Опорно-поворотное устройство/РМ-250 Привод РМ-210/Муфта соединительная.stl
19.0 x 19.0 x 25.0
