daniel-kurushin/arm-quantum/РМ-000 Рука-манипулятор/РМ-200 Опорно-поворотное устройство/РМ-262 Привод РМ-230/РМ-262-01 Корпус опорных подшипников РМ-262-09 для дивгателя РМ-262-04/РМ-262-01.stl

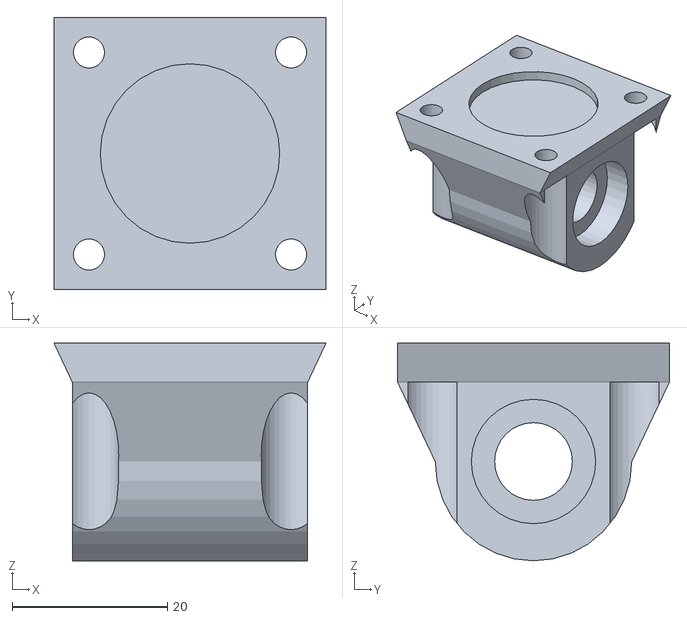
[picture p80: CAD file, 2019-08-08]
РМ-000 Рука-манипулятор/РМ-200 Опорно-поворотное устройство/РМ-262 Привод РМ-230/РМ-262-01 Корпус опорных подшипников РМ-262-09 для дивгателя РМ-262-04/РМ-262-01.stl
35.0 x 35.0 x 28.0
