daniel-kurushin/arm-quantum/РМ-000 Рука-манипулятор/РМ-500 Схват/clawsr.stl

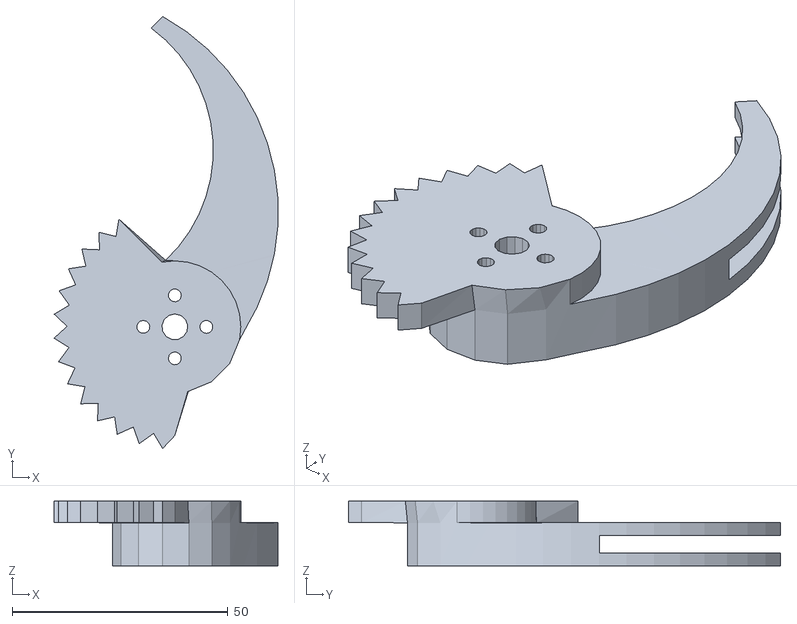
[picture p81: CAD file, 2021-01-24]
РМ-000 Рука-манипулятор/РМ-500 Схват/clawsr.stl
51.9 x 100.1 x 15.0
