daniel-kurushin/arm-quantum/РМ-000 Рука-манипулятор/РМ-100 Шасси/РМ-120 Винтовые упоры/Кронштейн.stl

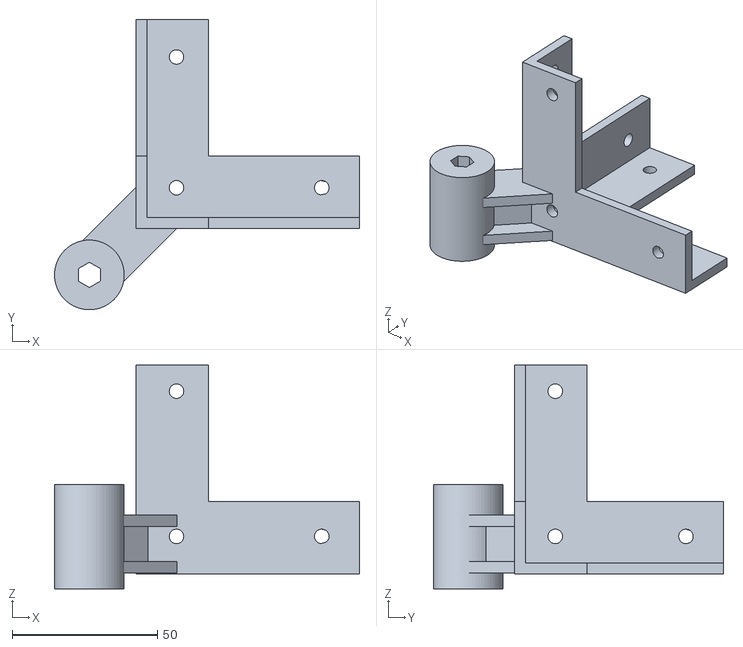
[picture p83: CAD file, 2019-08-21]
РМ-000 Рука-манипулятор/РМ-100 Шасси/РМ-120 Винтовые упоры/Кронштейн.stl
105.0 x 100.0 x 77.1
