daniel-kurushin/arm-quantum/РМ-000 Рука-манипулятор/РМ-100 Шасси/стойки для плат.stl

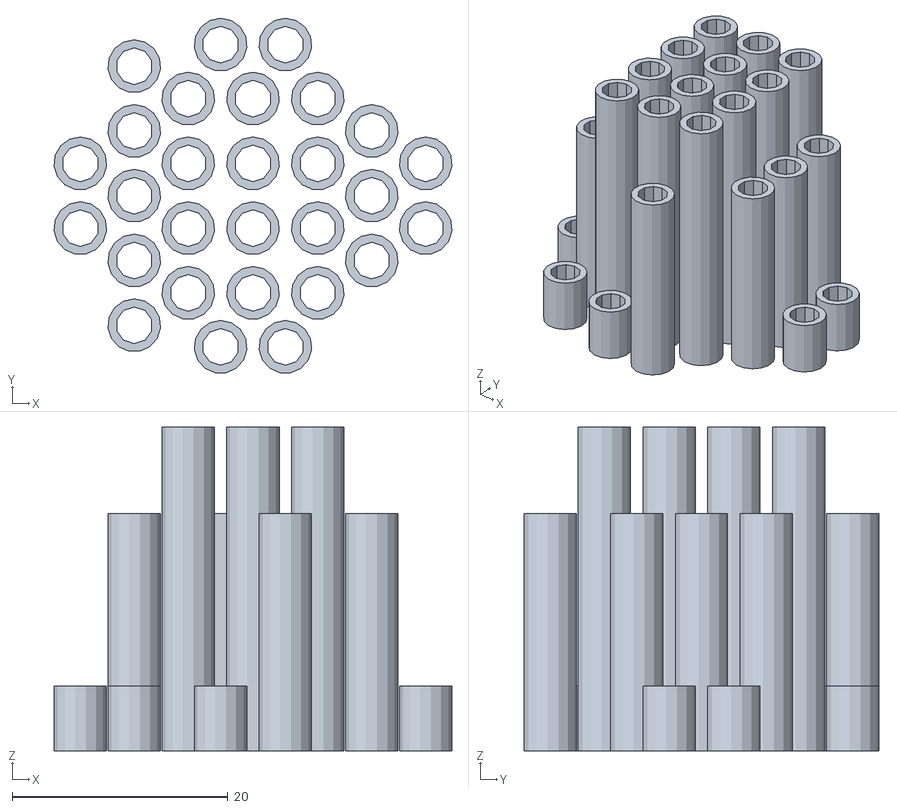
[picture p84: CAD file, 2019-09-15]
РМ-000 Рука-манипулятор/РМ-100 Шасси/стойки для плат.stl
36.9 x 32.8 x 30.0
