daniel-kurushin/arm-quantum/РМ-000 Рука-манипулятор/РМ-200 Опорно-поворотное устройство/РМ-220 Стрела/соединитель-8.stl

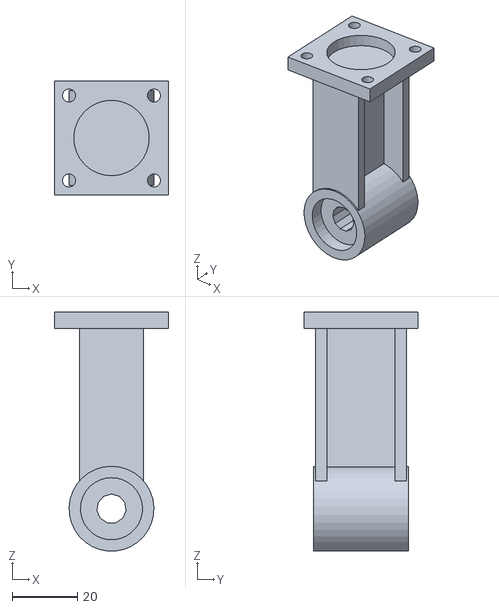
[picture p85: CAD file, 2019-09-23]
РМ-000 Рука-манипулятор/РМ-200 Опорно-поворотное устройство/РМ-220 Стрела/соединитель-8.stl
35.0 x 35.0 x 73.2
