daniel-kurushin/arm-quantum/РМ-000 Рука-манипулятор/РМ-200 Опорно-поворотное устройство/РМ-250 Привод РМ-210/Двигатель шаговый.stl

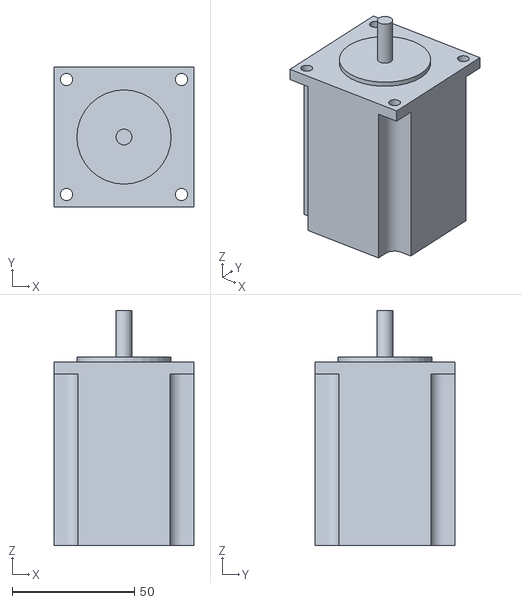
[picture p86: CAD file, 2019-08-10]
РМ-000 Рука-манипулятор/РМ-200 Опорно-поворотное устройство/РМ-250 Привод РМ-210/Двигатель шаговый.stl
57.0 x 57.0 x 96.0
