daniel-kurushin/arm-quantum/РМ-000 Рука-манипулятор/РМ-500 Схват/claws.stl

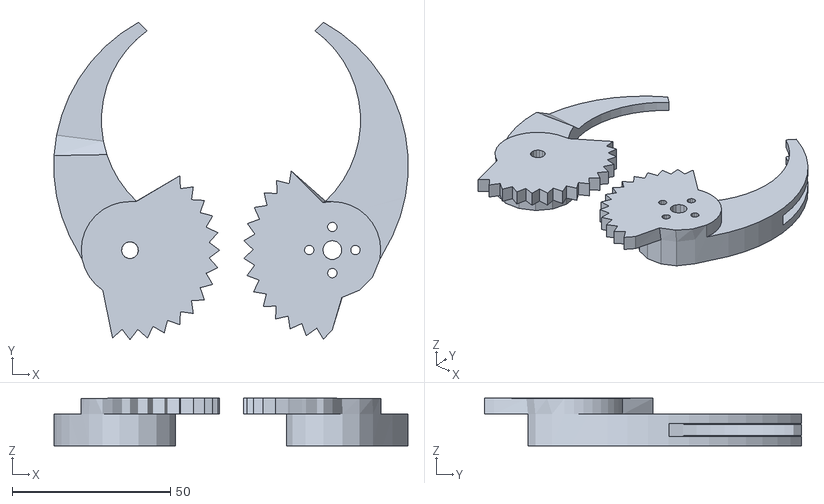
[picture p87: CAD file, 2021-01-24]
РМ-000 Рука-манипулятор/РМ-500 Схват/claws.stl
111.8 x 100.3 x 15.0
