daniel-kurushin/arm-quantum/РМ-000 Рука-манипулятор/РМ-100 Шасси/корпус турбины насоса-3.stl

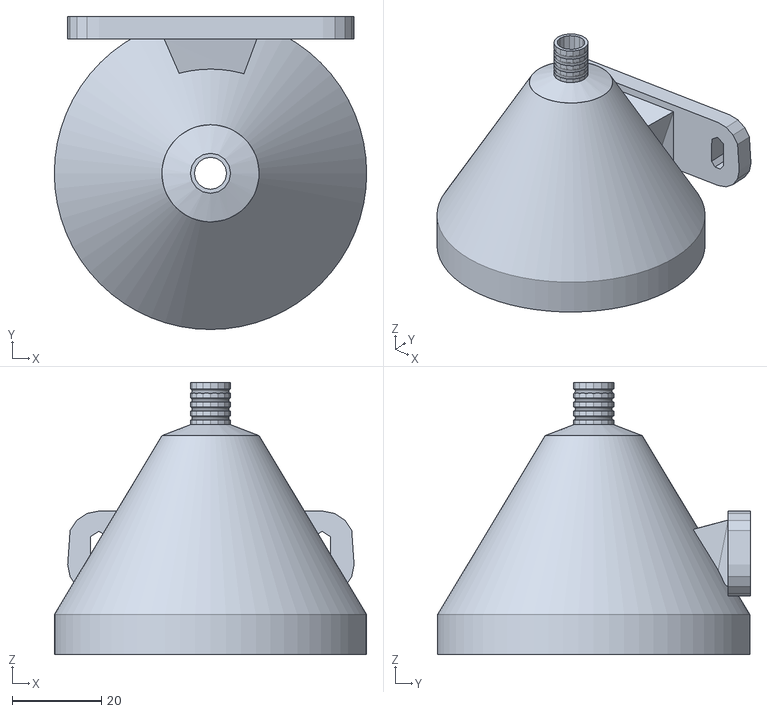
[picture p89: CAD file, 2019-09-15]
РМ-000 Рука-манипулятор/РМ-100 Шасси/корпус турбины насоса-3.stl
70.0 x 70.1 x 61.0
