daniel-kurushin/arm-quantum/РМ-000 Рука-манипулятор/РМ-100 Шасси/РМ-120 Винтовые упоры/Vrashalka.stl

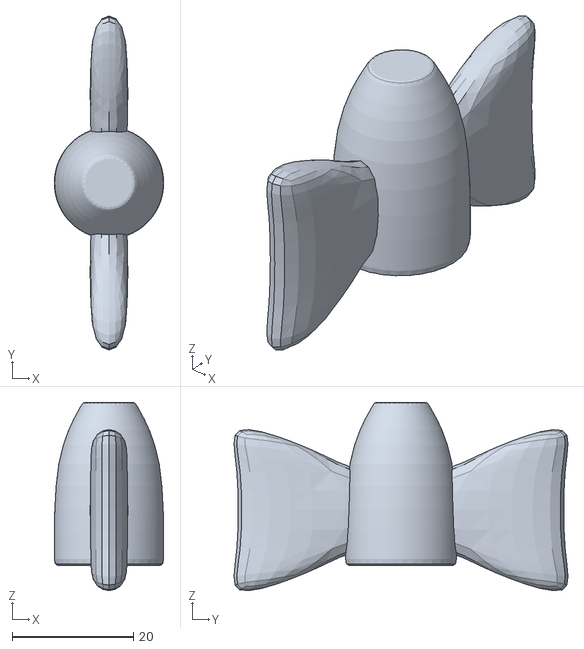
[picture p90: CAD file, 2019-08-21]
РМ-000 Рука-манипулятор/РМ-100 Шасси/РМ-120 Винтовые упоры/Vrashalka.stl
18.0 x 55.0 x 31.0
