daniel-kurushin/arm-quantum/РМ-000 Рука-манипулятор/РМ-200 Опорно-поворотное устройство/РМ-220 Стрела/соединитель-7.stl

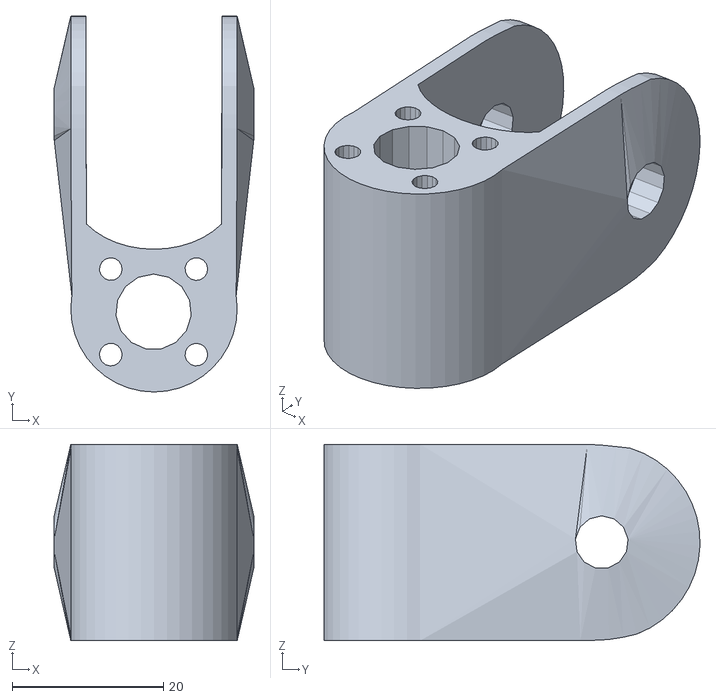
[picture p91: CAD file, 2019-09-23]
РМ-000 Рука-манипулятор/РМ-200 Опорно-поворотное устройство/РМ-220 Стрела/соединитель-7.stl
26.4 x 49.7 x 26.0
