daniel-kurushin/arm-quantum/РМ-000 Рука-манипулятор/РМ-500 Схват/clawsb.stl

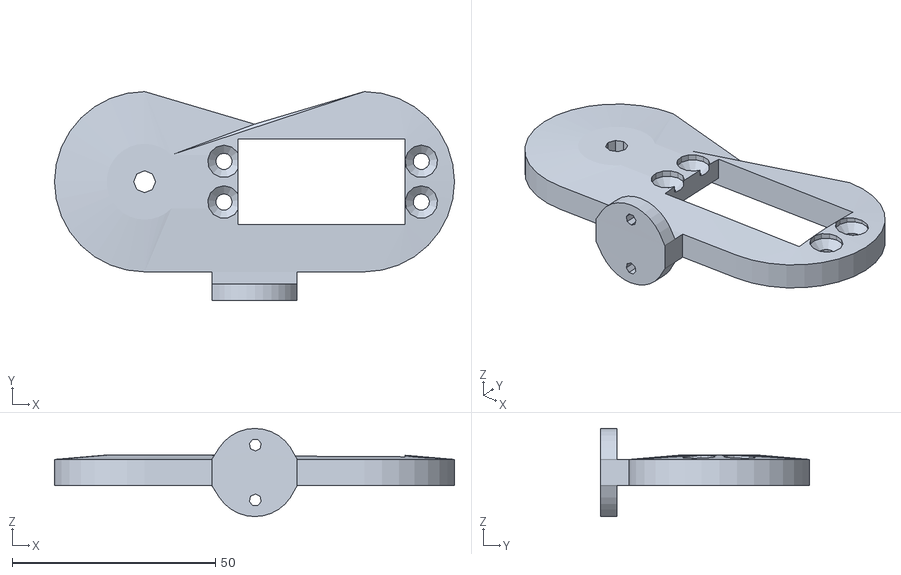
[picture p92: CAD file, 2019-09-27]
РМ-000 Рука-манипулятор/РМ-500 Схват/clawsb.stl
98.3 x 51.3 x 21.7
