daniel-kurushin/arm-quantum/РМ-000 Рука-манипулятор/РМ-600 Пульт управления/РМ-630 Управляющая ЭВМ/РМ-632 Устройства отображения информации/РМ-632-01 Кронштейн и корпус монитора/small-monitor-frame-h.stl

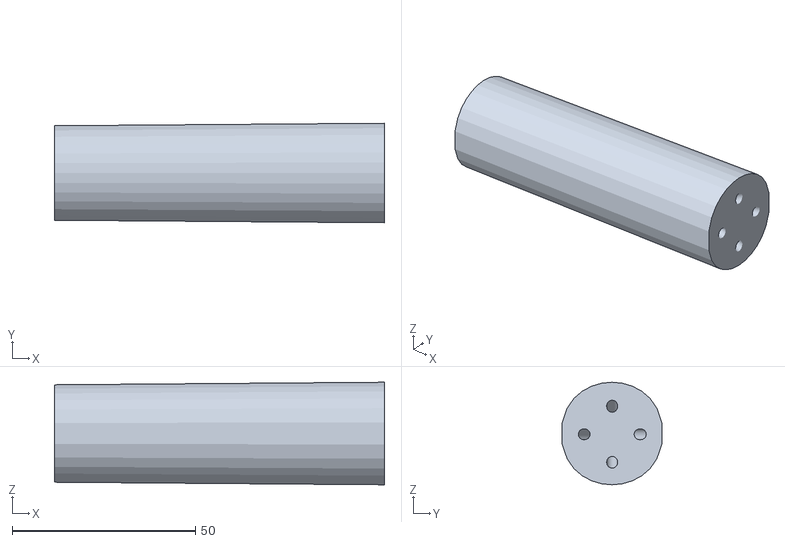
[picture p93: CAD file, 2021-10-18]
РМ-000 Рука-манипулятор/РМ-600 Пульт управления/РМ-630 Управляющая ЭВМ/РМ-632 Устройства отображения информации/РМ-632-01 Кронштейн и корпус монитора/small-monitor-frame-h.stl
90.0 x 27.1 x 28.0
