daniel-kurushin/arm-quantum/РМ-000 Рука-манипулятор/РМ-100 Шасси/пружинная вставка.stl

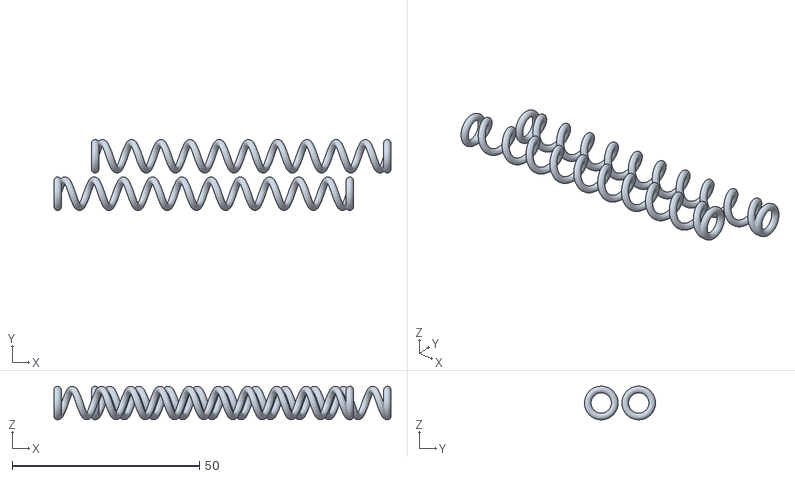
[picture p94: CAD file, 2019-09-15]
РМ-000 Рука-манипулятор/РМ-100 Шасси/пружинная вставка.stl
90.0 x 19.0 x 9.00
