daniel-kurushin/arm-quantum/РМ-000 Рука-манипулятор/РМ-100 Шасси/РМ-120 Винтовые упоры/Упор.stl

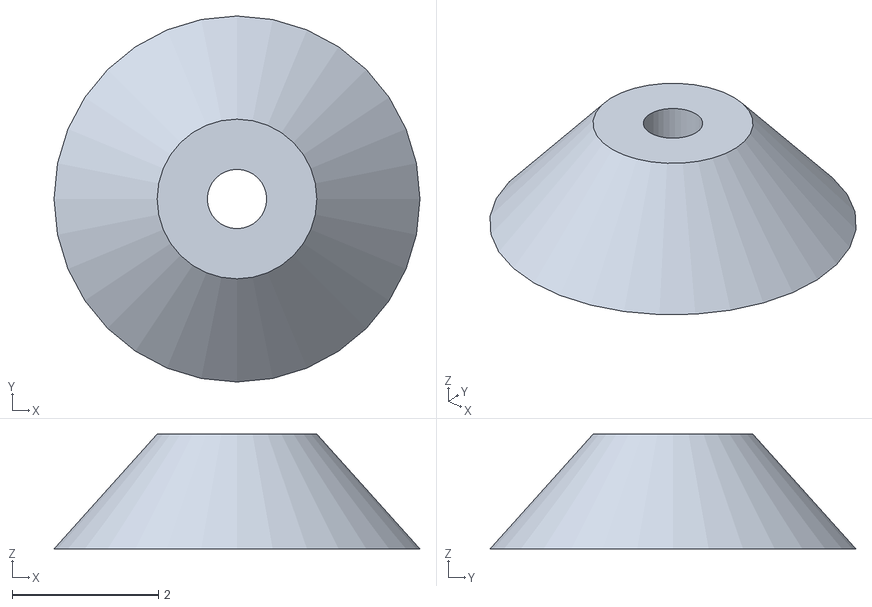
[picture p95: CAD file, 2019-08-21]
РМ-000 Рука-манипулятор/РМ-100 Шасси/РМ-120 Винтовые упоры/Упор.stl
5.00 x 5.00 x 1.57
