daniel-kurushin/arm-quantum/РМ-000 Рука-манипулятор/РМ-200 Опорно-поворотное устройство/РМ-220 Стрела/соединитель-2.stl

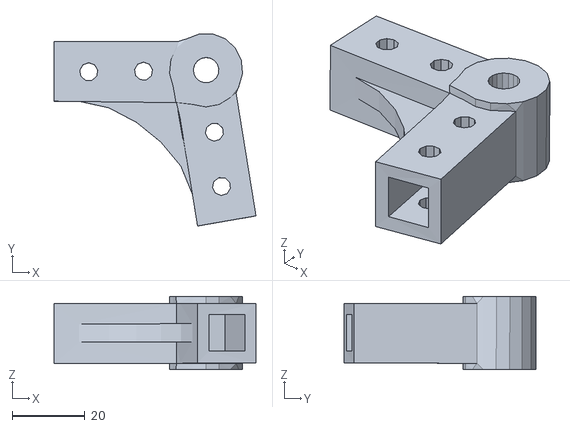
[picture p96: CAD file, 2019-09-15]
РМ-000 Рука-манипулятор/РМ-200 Опорно-поворотное устройство/РМ-220 Стрела/соединитель-2.stl
55.4 x 52.7 x 20.0
