daniel-kurushin/arm-quantum/РМ-000 Рука-манипулятор/РМ-100 Шасси/крыльчатка турбины насоса-2.stl

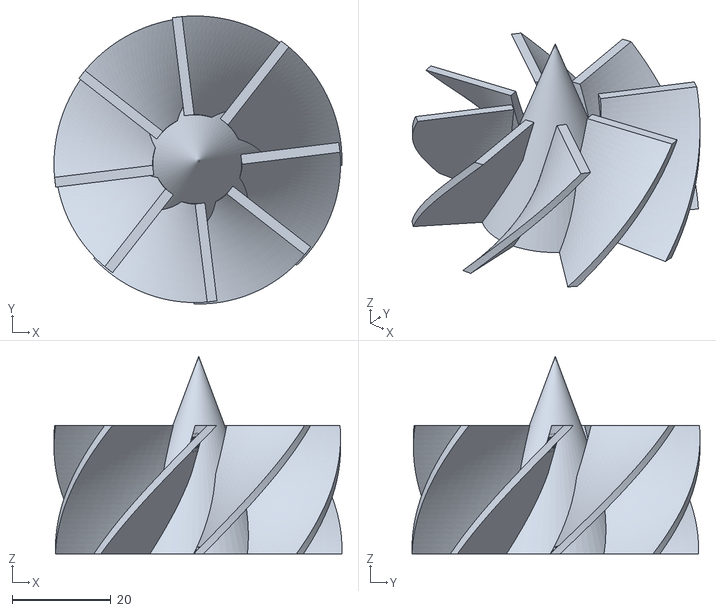
[picture p98: CAD file, 2019-09-06]
РМ-000 Рука-манипулятор/РМ-100 Шасси/крыльчатка турбины насоса-2.stl
58.3 x 58.3 x 40.0
