daniel-kurushin/arm-quantum/РМ-000 Рука-манипулятор/РМ-200 Опорно-поворотное устройство/РМ-220 Стрела/соединитель-1.stl

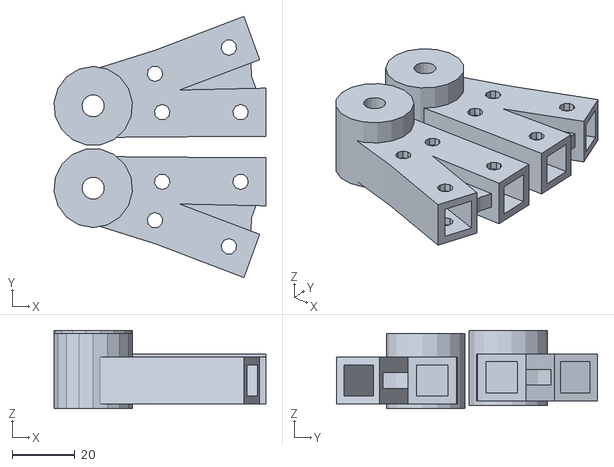
[picture p99: CAD file, 2019-09-15]
РМ-000 Рука-манипулятор/РМ-200 Опорно-поворотное устройство/РМ-220 Стрела/соединитель-1.stl
67.6 x 83.3 x 25.0
