daniel-kurushin/arm-quantum/РМ-000 Рука-манипулятор/РМ-100 Шасси/крыльчатка турбины насоса-3.stl

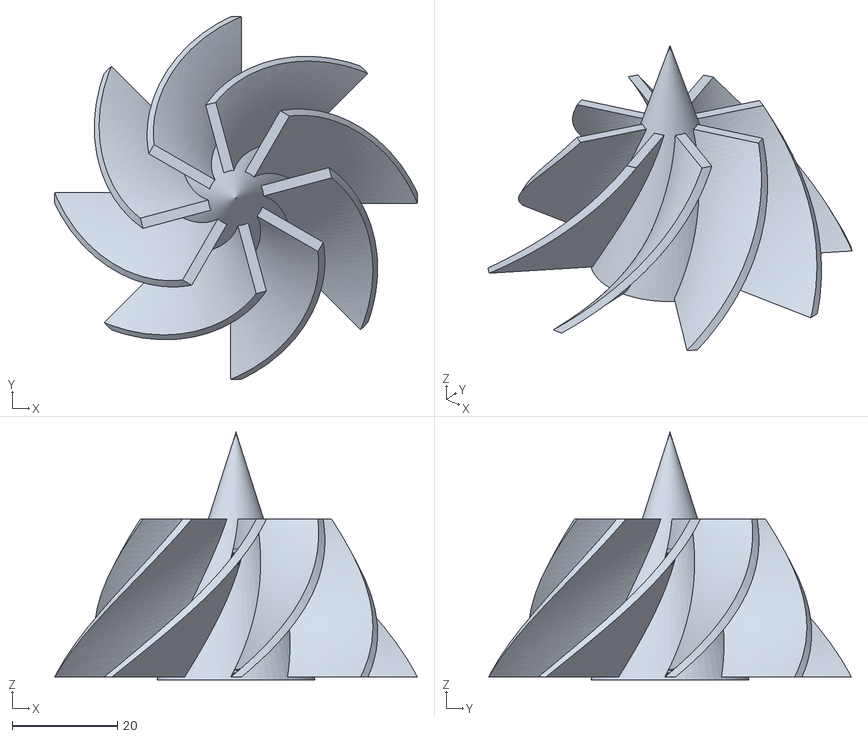
[picture p101: CAD file, 2019-09-06]
РМ-000 Рука-манипулятор/РМ-100 Шасси/крыльчатка турбины насоса-3.stl
68.9 x 68.9 x 47.0
