daniel-kurushin/arm-quantum/РМ-000 Рука-манипулятор/РМ-100 Шасси/корпус турбины насоса.stl

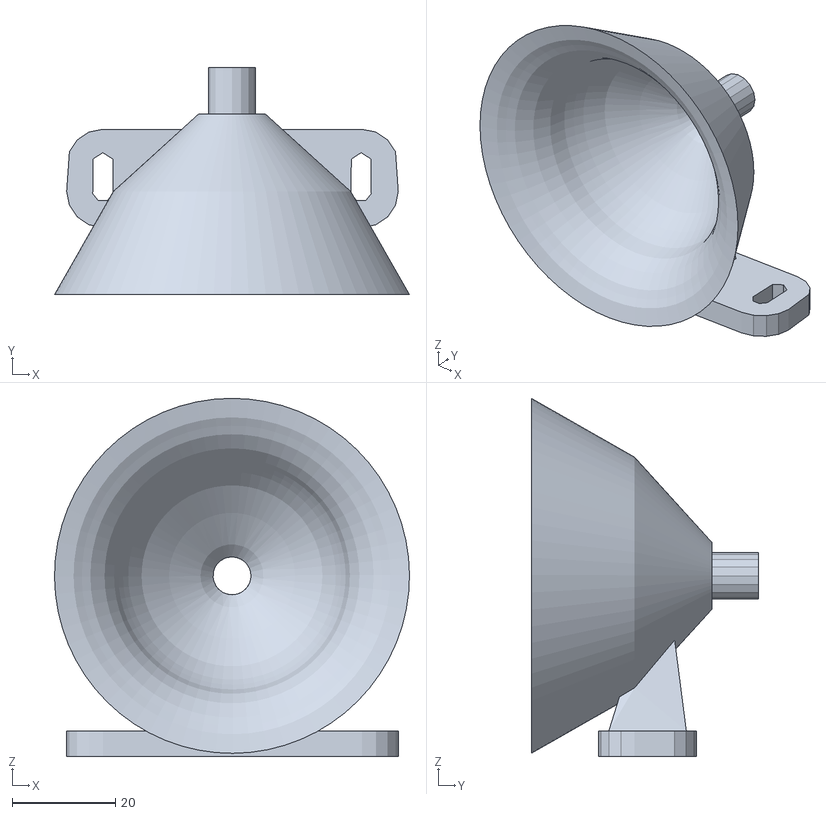
[picture p104: CAD file, 2019-09-06]
РМ-000 Рука-манипулятор/РМ-100 Шасси/корпус турбины насоса.stl
68.7 x 44.0 x 69.4
