daniel-kurushin/arm-quantum/РМ-000 Рука-манипулятор/РМ-100 Шасси/кронштейн насоса.stl

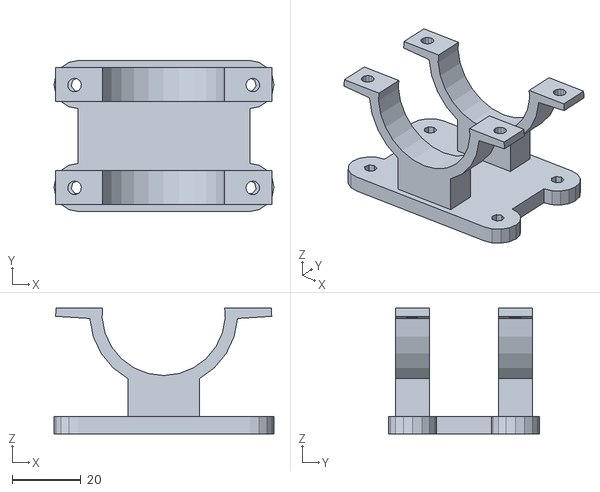
[picture p107: CAD file, 2019-09-05]
РМ-000 Рука-манипулятор/РМ-100 Шасси/кронштейн насоса.stl
64.2 x 44.0 x 36.6
