daniel-kurushin/arm-quantum/РМ-000 Рука-манипулятор/РМ-200 Опорно-поворотное устройство/РМ-220 Стрела/корпус-ходовых-гаек.stl

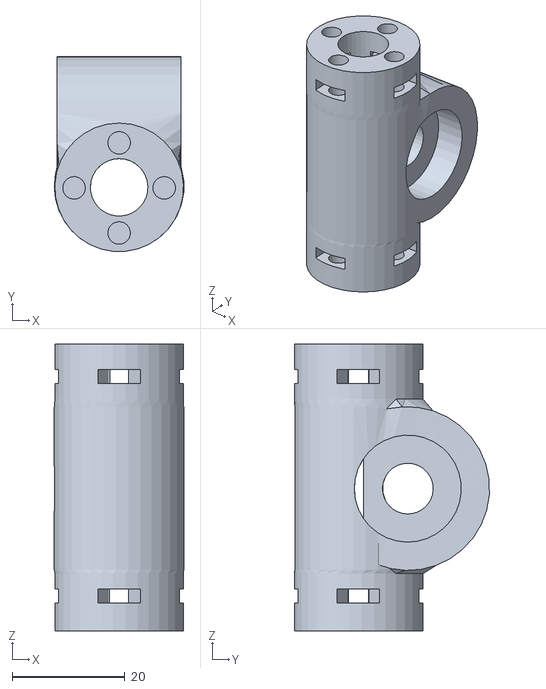
[picture p108: CAD file, 2019-09-03]
РМ-000 Рука-манипулятор/РМ-200 Опорно-поворотное устройство/РМ-220 Стрела/корпус-ходовых-гаек.stl
23.0 x 34.6 x 51.0
