daniel-kurushin/arm-quantum/РМ-000 Рука-манипулятор/РМ-100 Шасси/крыльчатка турбины насоса-1.stl

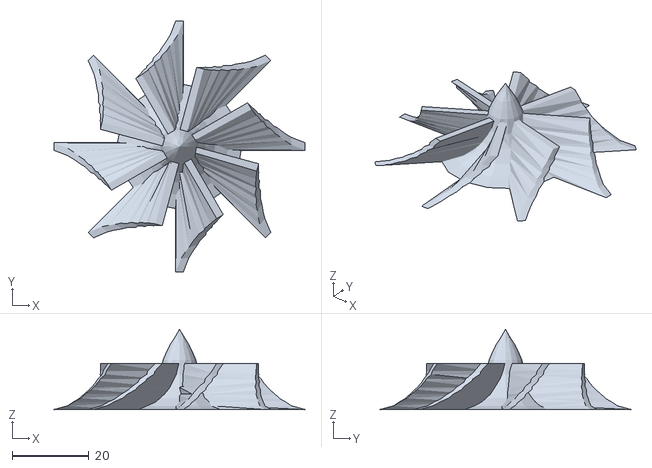
[picture p110: CAD file, 2019-09-05]
РМ-000 Рука-манипулятор/РМ-100 Шасси/крыльчатка турбины насоса-1.stl
65.4 x 65.4 x 21.0
