daniel-kurushin/arm-quantum/РМ-000 Рука-манипулятор/РМ-100 Шасси/наметки насоса.stl

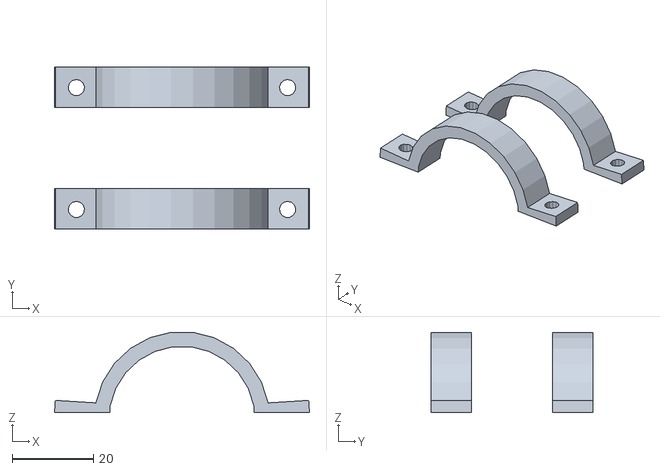
[picture p112: CAD file, 2019-09-05]
РМ-000 Рука-манипулятор/РМ-100 Шасси/наметки насоса.stl
62.8 x 40.0 x 19.8
