daniel-kurushin/arm-quantum/РМ-000 Рука-манипулятор/РМ-200 Опорно-поворотное устройство/РМ-220 Стрела/рама-1.stl

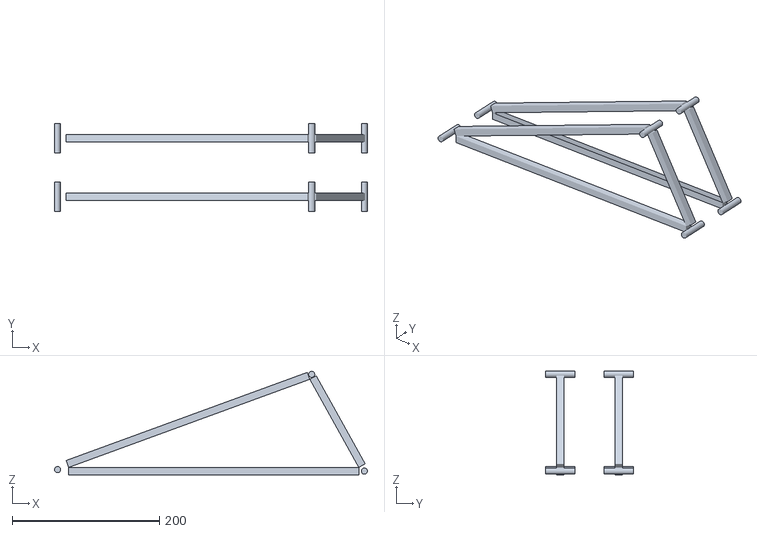
[picture p113: CAD file, 2019-08-31]
РМ-000 Рука-манипулятор/РМ-200 Опорно-поворотное устройство/РМ-220 Стрела/рама-1.stl
425.5 x 120.0 x 140.8
