daniel-kurushin/arm-quantum/РМ-000 Рука-манипулятор/РМ-100 Шасси/крепеж-ардуино.stl

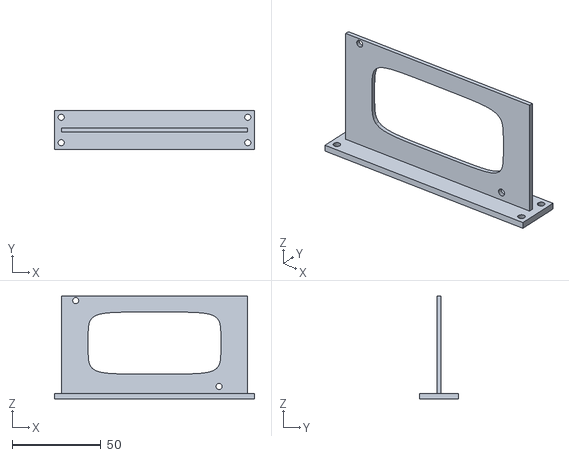
[picture p114: CAD file, 2019-09-03]
РМ-000 Рука-манипулятор/РМ-100 Шасси/крепеж-ардуино.stl
113.0 x 22.0 x 58.0
