daniel-kurushin/arm-quantum/РМ-000 Рука-манипулятор/РМ-200 Опорно-поворотное устройство/РМ-220 Стрела/шарниры.stl

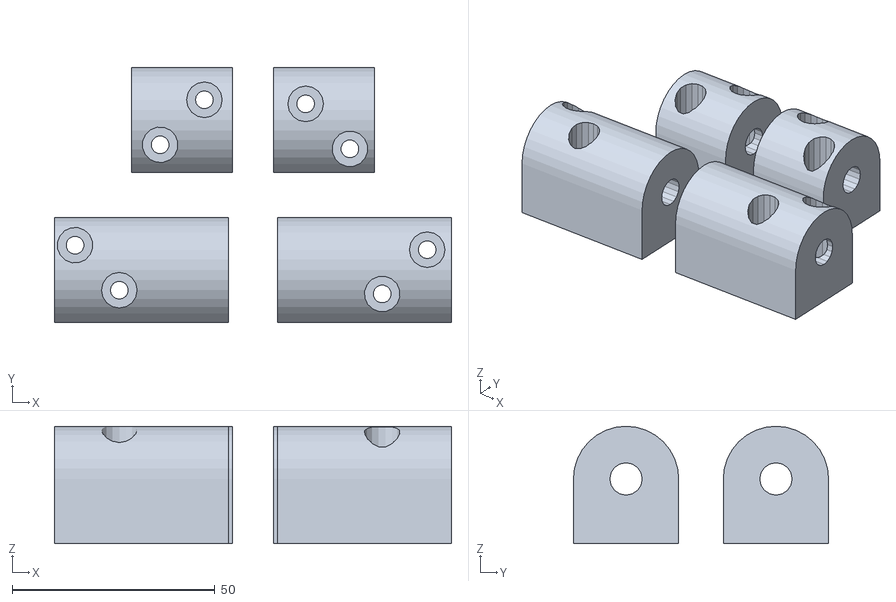
[picture p115: CAD file, 2019-08-23]
РМ-000 Рука-манипулятор/РМ-200 Опорно-поворотное устройство/РМ-220 Стрела/шарниры.stl
98.0 x 63.0 x 29.0
