daniel-kurushin/arm-quantum/(list of files, cad)

Other CAD files:
old/Umno/Cronshtein.blend
old/Umno/MANIPULYaTOR.blend
old/Umno/V-Вилка.blend
old/Umno/Vrashalka.blend
old/Umno/bgerobot.blend
old/Umno/untitled.blend
old/Umno/Аккамулятор.blend
old/Umno/Двигалка.blend
old/Umno/Клешни.blend
old/Umno/Коробка-в-Сборе.blend
old/Umno/Крышка для ящика манипулятора.blend
old/Umno/Макет манипулятора.blend
old/Umno/РМ-муфта-соединительная.stl
old/Umno/РМ-шкив-большой.stl
old/Umno/корпус-в-сборе.stl
РМ-000 Рука-манипулятор/РМ-200 Опорно-поворотное устройство/РМ-200-ОПУ-в-сборе.blend
РМ-000 Рука-манипулятор/РМ-200 Опорно-поворотное устройство/РМ-262 Привод РМ-230/РМ-262-в-сборе.blend
РМ-000 Рука-манипулятор/РМ-600 Пульт управления/РМ-630 Управляющая ЭВМ/РМ-632 Устройства отображения информации/РМ-632-01 Кронштейн и корпус монитора/small-monitor-stand.blend
