daniel-kurushin/arm-quantum/(list of files, drawings)

Other design files:
схема электрическая.fzz
