daniel-kurushin/arm-quantum/src/by_joystick/pins.h

#define led5 7
#define led4 6
#define led3 5
#define led2 4
#define led1 A4

#define y    A7
#define x    A6
#define knok A5

#define mot1_en   53
#define mot1_dir  51
#define mot1_step 49

#define mot2_5v   47
#define mot2_en_  35
#define mot2_cw   33
#define mot2_clk  45
