daniel-kurushin/arm-quantum/(commit log)

2019-08-06 структура проекта
2019-08-07 х*рня
    [MANIPULYaTOR.blend]
2019-08-07 Changes for arduino
2019-08-08 обновления структуры
2019-08-08 stl и blend файлыэ
    [РМ-220-в-сборе.blend, РМ-261-01.stl, РМ-261-02.stl, РМ-261-03.stl]
2019-08-08 пояснения по ШД
2019-08-08 пояснения по подшипнику
2019-08-08 пояснения по ходовому винту
2019-08-08 пояснения по корпусу
2019-08-08 пояснения по корпусу ходового винта
2019-08-08 пояснения по монтажу муфты
2019-08-08 крепеж
2019-08-08 РМ-262 очень похож на РМ-261, вероятно будет отличаться только длиной
    [РМ-261-01.stl, РМ-261-02.stl, РМ-261-03.stl, РМ-262-в-сборе.blend]
2019-08-09 муфта пофиксена
    [РМ-261-03.stl, РМ-262-03.stl]
2019-08-09 реализовано распознавание обЪектов
2019-08-09 модель
    [РМ-261-04 Двигатель шаговый.stl]
2019-08-10 Модель двигателя для ОПУ
    [Двигатель шаговый.stl, РМ-200-ОПУ-в-сборе.blend]
2019-08-10 реализовано распознавание объектов с камеры.Рассчитано перемещение по осям X и Y.
2019-08-10 Модель корпуса подшипников для NEMA
    [Шкив ведомый.stl, Муфта соединительная.stl, РМ-200-ОПУ-в-сборе.blend, РМ-261-01-1.stl]
2019-08-11 Тест шагового двигателя
2019-08-11 test positing step motor
2019-08-11 Создан класс Arduino
2019-08-11 шкив ведомый пофиксен
    [РМ-200-ОПУ-в-сборе.blend]
2019-08-11 создан класс Objects и функция photo
2019-08-11 поймано исключение при ненахождении объекта на снимке
2019-08-13 шкив ведомый д 165ммэ
    [Шкив ведомый-1.stl, РМ-200-ОПУ-в-сборе.blend]
2019-08-13 опорный подшипник
    [Обойма опорного подшипника.stl, Опорный подшипник.stl, РМ-200-ОПУ-в-сборе.blend]
2019-08-14 Create рука тест
2019-08-14 реализована структура классов
2019-08-14 RM-431 Распознавание образов
2019-08-14 корпус центрального подшипника
    [Корпус подшипника.stl, РМ-200-ОПУ-в-сборе.blend]
2019-08-14 Калибровка привода
2019-08-14 Обновления структуры проекта
    [Шкив ведомый-1.stl, Шкив ведомый.stl, Cепаратор опорного подшипника.stl, Корпус подшипника.stl, Опорный подшипник.stl, РМ-200-ОПУ-в-сборе.blend]
2019-08-14 Шкивы
    [РМ-200-ОПУ-в-сборе.blend, Шкив ведущий.stl, шкив.stl]
2019-08-18 датчик положения - натяжитель
    [РМ-200-ОПУ-в-сборе.blend]
2019-08-18 структура
    [корпус.stl, крышка.stl, рычаг.stl, шкив.stl]
2019-08-19 реализовано перемещение линейного привода
2019-08-19 стрела
    [основание.stl, шкив-1.stl]
2019-08-21 опоры
    [Шкив ведомый-1.stl, Vrashalka.stl, Кронштейн.stl, Кронштейн4.stl, Упор.stl]
2019-08-21 опорный подшипник собран
2019-08-22 Винтовые упоры
2019-08-23 винтовой упор собран
2019-08-23 переделано основание опорного подшипника, собран корпус для моделирования внутрянки, подготовлен к печати узел шарнира стрелы
    [АКБ-1.stl, АКБ.stl, Опорный подшипник-1.stl, шарниры.stl]
2019-08-23 процесс сборки шасси
2019-08-24 Коробка с крепежом под электронику
    [Коробка-в-Сборе.blend]
2019-08-26 коробка в процессе сборки, шарнир напечатан
2019-08-26 коробка в процессе сборки
2019-08-27 Коробочка с крепежами под электронику(v2)
    [Коробка-в-Сборе.blend]
2019-08-28 Календарь
2019-08-31 Фото
    [untitled.stl, рама-1.stl, соединитель-1.stl]
2019-08-31 create driver wiring
2019-09-01 предварительная сборка элемента стрелы
2019-09-01 переделан шарнир стрелы, добавлены посадочные места для подшипников
    [соединитель-2.stl]
2019-09-01 привод стрелы
    [соединитель-3.stl]
2019-09-03 крепление ДУЕ и корпус ходовых гаек
    [корпус-ходовых-гаек.stl, крепеж-ардуино.stl]
2019-09-05 насос
    [корпус турбины насоса.stl, кронштейн насоса.stl, крыльчатка турбины насоса-1.stl, наметки насоса.stl]
2019-09-06 вентилятор, разные версии
    [корпус турбины насоса.stl, крыльчатка турбины насоса-2.stl, крыльчатка турбины насоса-3.stl]
2019-09-07 корпус насоса
    [корпус турбины насоса-3.stl]
2019-09-07 создан автомат управления пневматическим захватом
2019-09-10 упоры обновлены
    [Кронштейн-1.stl, соединитель-1.stl, соединитель-2.stl, стойки для плат.stl]
2019-09-10 упоры удалены из файла
2019-09-11 Add files via upload
    Захватик v.0.0.1
2019-09-12 Соединитель рукояти
    [пружинная вставка.stl, соединитель-4.stl]
2019-09-13 Кронштейн захвата
    [подвес захвата.stl, соединитель-5.stl]
2019-09-15 V-Вилка
    Для мотора
    [V-Вилка.blend]
2019-09-16 корпус подшипников
    [РМ-262-02.stl]
2019-09-20 реализовано управление моторами через порт ардуино
2019-09-21 parser & printer
2019-09-21 переписо общение с ардуино
2019-09-24 calibration ultrasonic sensor
2019-09-24 colibration ultrasonic
2019-09-27 mostly finished
    [clawsb.stl, clawsl.stl, clawsr.stl]
2019-09-29 Для владика манипулятора макетъ
    [Макет манипулятора.blend]
2019-09-29 arduino command system
2019-09-30 bge0.1
    Что удалось реализовать:
    Поворот на a/d
    Коллизия и относительно родители
    С чем возникли проблемы:
    Клешни коцают предметы на лкм/пкм, но не поднимаются вместе с их держалкой, т.к. при создании связи родители-предки, они попросту улетают в воздух((
    Вторая стрела манипулятора передвигается с проблемами, пока думаю, как решить
    +снята пара коротких видеороликов
2019-09-30 bge.robot(v.01 - теперь нормик)
    +снята пара коротких видеороликов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
    [bgerobot.blend]
2019-10-01 reverce kinematic
2019-10-01 reverse kinematics added
2019-10-10 новая клешня
    [шкив датчика_1.stl, шкив датчика_2.stl]
2019-10-10 sysytem comand
    [experement.csv, experement.ods]
2019-10-12 refactoring function Stepper1_go
2019-11-25 interrupt initialization
2019-12-10 Krishka manipulatora
    Крышка для ящика манипулятора.
    с разъемом под выключатель.
    [Крышка для ящика манипулятора.blend]
2019-12-12 stepper version 3
2021-10-04 test of ikpy
    [pyvenv.cfg]
2021-10-10 cхема
    [схема электрическая.fzz]
